Wildcat-Rocket-Engineering-Club/WRECtangle/Designs/PCB-DesignReviewFeedback.html

Export 563 message(s)



从 Wed Jan 07 2026 00:00:00 GMT-0700 (Mountain Standard Time) 到 Fri Feb 13 2026 00:00:00 GMT-0700 (Mountain Standard Time)

- 
  erzerumTue Feb 03 2026 21:35:38 GMT-0700 (Mountain Standard Time)
  @mr_arson#0
- 
  mr_arsonTue Feb 03 2026 21:35:42 GMT-0700 (Mountain Standard Time)
  okay chat
- 
  destroyo123Tue Feb 03 2026 21:35:46 GMT-0700 (Mountain Standard Time)
  hello!
- 
  mr_arsonTue Feb 03 2026 21:35:46 GMT-0700 (Mountain Standard Time)
  here is the bit
- 
  erzerumTue Feb 03 2026 21:35:46 GMT-0700 (Mountain Standard Time)
  cross country pcb review
- 
  destroyo123Tue Feb 03 2026 21:35:53 GMT-0700 (Mountain Standard Time)
  it is board review time
- 
  mr_arsonTue Feb 03 2026 21:35:59 GMT-0700 (Mountain Standard Time)
  have you ordered a pcb before
- 
  destroyo123Tue Feb 03 2026 21:36:04 GMT-0700 (Mountain Standard Time)
  this was first
- 
  destroyo123Tue Feb 03 2026 21:37:08 GMT-0700 (Mountain Standard Time)
- 
  mr_arsonTue Feb 03 2026 21:37:30 GMT-0700 (Mountain Standard Time)
  I think you could do a pretty good job competing with the average senior electrical engineer from my university at pcb design
- 
  destroyo123Tue Feb 03 2026 21:37:52 GMT-0700 (Mountain Standard Time)
  no way
- 
  destroyo123Tue Feb 03 2026 21:37:55 GMT-0700 (Mountain Standard Time)
  that's huge
- 
  destroyo123Tue Feb 03 2026 21:38:16 GMT-0700 (Mountain Standard Time)
  still probably a lot of issues I didn't even have time to adjust the silkscreens
- 
  destroyo123Tue Feb 03 2026 21:38:21 GMT-0700 (Mountain Standard Time)
  but that's huge thank you
- 
  mr_arsonTue Feb 03 2026 21:39:02 GMT-0700 (Mountain Standard Time)
  people take like a whole semester of "how mosfets physically work on the silicon level" and then don't put pulldown resistors it's a huge meme
- 
  destroyo123Tue Feb 03 2026 21:39:27 GMT-0700 (Mountain Standard Time)
  heh Yeah that sounds kinda funny
- 
  destroyo123Tue Feb 03 2026 21:39:32 GMT-0700 (Mountain Standard Time)
  "why is it still on?"
- 
  mr_arsonTue Feb 03 2026 21:40:19 GMT-0700 (Mountain Standard Time)
  once i placed series capacitors on the gate drive of fets. they would turn on for ~200ms. that was an ordering mistake tho
- 
  mr_arsonTue Feb 03 2026 21:41:10 GMT-0700 (Mountain Standard Time)
  what are we doing
  图片附件
- 
  destroyo123Tue Feb 03 2026 21:41:14 GMT-0700 (Mountain Standard Time)
  gate drive is the trigger signal basically right? so it would just stay on a little longer
- 
  mr_arsonTue Feb 03 2026 21:41:22 GMT-0700 (Mountain Standard Time)
  no because series capacitor blocks dc
- 
  destroyo123Tue Feb 03 2026 21:41:31 GMT-0700 (Mountain Standard Time)
  @mr_arson#0 okay so TI Powerbench told me to
- 
  destroyo123Tue Feb 03 2026 21:41:38 GMT-0700 (Mountain Standard Time)
  because I don't know how to design a power system
- 
  destroyo123Tue Feb 03 2026 21:41:53 GMT-0700 (Mountain Standard Time)
  📎 3.3V-Circuit.pdf?ex=6990a5d1&is=698f5451&hm=4855e791037637a58043e073c8e2e341926000bcf0f89aaae055b9305625b81f& (https://cdn.discordapp.com/attachments/1468464998379425875/1468466570685714432/3.3V-Circuit.pdf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)
- 
  mr_arsonTue Feb 03 2026 21:42:03 GMT-0700 (Mountain Standard Time)
  smart move
- 
  mr_arsonTue Feb 03 2026 21:42:03 GMT-0700 (Mountain Standard Time)
  however
- 
  destroyo123Tue Feb 03 2026 21:42:10 GMT-0700 (Mountain Standard Time)
  this is true
- 
  mr_arsonTue Feb 03 2026 21:42:13 GMT-0700 (Mountain Standard Time)
  when you put capacitors in series they do this bullshit
- 
  mr_arsonTue Feb 03 2026 21:42:48 GMT-0700 (Mountain Standard Time)
  图片附件
- 
  mr_arsonTue Feb 03 2026 21:42:56 GMT-0700 (Mountain Standard Time)
  halves the capacitance. or thirds it, in this case
- 
  destroyo123Tue Feb 03 2026 21:43:09 GMT-0700 (Mountain Standard Time)
  riiiiht?
- 
  mr_arsonTue Feb 03 2026 21:43:16 GMT-0700 (Mountain Standard Time)
  ti wants you to put them in parallel to increase the capacitance
- 
  destroyo123Tue Feb 03 2026 21:43:18 GMT-0700 (Mountain Standard Time)
  oh.
- 
  destroyo123Tue Feb 03 2026 21:43:21 GMT-0700 (Mountain Standard Time)
  dammit
- 
  mr_arsonTue Feb 03 2026 21:43:22 GMT-0700 (Mountain Standard Time)
  series capacitors are a no-go
- 
  mr_arsonTue Feb 03 2026 21:43:29 GMT-0700 (Mountain Standard Time)
  the only reason is to increase voltage ratings
- 
  destroyo123Tue Feb 03 2026 21:43:32 GMT-0700 (Mountain Standard Time)
  okay so that was misinterpereting the datasheet
- 
  mr_arsonTue Feb 03 2026 21:43:33 GMT-0700 (Mountain Standard Time)
  but that has other big problems
- 
  destroyo123Tue Feb 03 2026 21:43:45 GMT-0700 (Mountain Standard Time)
  darn
- 
  destroyo123Tue Feb 03 2026 21:43:46 GMT-0700 (Mountain Standard Time)
  good to know
- 
  mr_arsonTue Feb 03 2026 21:43:48 GMT-0700 (Mountain Standard Time)
  the datasheet tells you to place something about 10u
- 
  destroyo123Tue Feb 03 2026 21:44:08 GMT-0700 (Mountain Standard Time)
  could be fixed by bridging the other two and then putting one equivalent cap
- 
  mr_arsonTue Feb 03 2026 21:44:22 GMT-0700 (Mountain Standard Time)
  wait did you order this already
- 
  destroyo123Tue Feb 03 2026 21:44:25 GMT-0700 (Mountain Standard Time)
  yes
- 
  destroyo123Tue Feb 03 2026 21:44:39 GMT-0700 (Mountain Standard Time)
  I also made the mistake of not having them assemble it
- 
  destroyo123Tue Feb 03 2026 21:44:42 GMT-0700 (Mountain Standard Time)
  I have regrets
- 
  erzerumTue Feb 03 2026 21:44:45 GMT-0700 (Mountain Standard Time)
  lol
- 
  erzerumTue Feb 03 2026 21:44:49 GMT-0700 (Mountain Standard Time)
  told you so
- 
  mr_arsonTue Feb 03 2026 21:44:49 GMT-0700 (Mountain Standard Time)
  chat
- 
  destroyo123Tue Feb 03 2026 21:45:05 GMT-0700 (Mountain Standard Time)
  you were probably pretty right on that one
- 
  mr_arsonTue Feb 03 2026 21:45:12 GMT-0700 (Mountain Standard Time)
  图片附件
- 
  mr_arsonTue Feb 03 2026 21:45:52 GMT-0700 (Mountain Standard Time)
  have fun bodging that
  图片附件
- 
  mr_arsonTue Feb 03 2026 21:46:06 GMT-0700 (Mountain Standard Time)
  oh man its wqfn too
- 
  destroyo123Tue Feb 03 2026 21:46:11 GMT-0700 (Mountain Standard Time)
  ah fuck I even ran a DRC
- 
  destroyo123Tue Feb 03 2026 21:46:14 GMT-0700 (Mountain Standard Time)
  dammit
- 
  mr_arsonTue Feb 03 2026 21:46:23 GMT-0700 (Mountain Standard Time)
  it's worth running ERC even tho half of ERC is dumb bullshit
- 
  mr_arsonTue Feb 03 2026 21:46:33 GMT-0700 (Mountain Standard Time)
  but also this is what it looks like
- 
  mr_arsonTue Feb 03 2026 21:46:34 GMT-0700 (Mountain Standard Time)
  图片附件
- 
  destroyo123Tue Feb 03 2026 21:46:36 GMT-0700 (Mountain Standard Time)
  ERC is schematics?
- 
  mr_arsonTue Feb 03 2026 21:46:38 GMT-0700 (Mountain Standard Time)
  yea
- 
  mr_arsonTue Feb 03 2026 21:46:42 GMT-0700 (Mountain Standard Time)
  electrical rules checker or whatever
- 
  destroyo123Tue Feb 03 2026 21:46:42 GMT-0700 (Mountain Standard Time)
  how did I not
- 
  destroyo123Tue Feb 03 2026 21:46:43 GMT-0700 (Mountain Standard Time)
  know
- 
  destroyo123Tue Feb 03 2026 21:46:44 GMT-0700 (Mountain Standard Time)
  that
- 
  destroyo123Tue Feb 03 2026 21:46:45 GMT-0700 (Mountain Standard Time)
  these
- 
  destroyo123Tue Feb 03 2026 21:46:46 GMT-0700 (Mountain Standard Time)
  exist
- 
  mr_arsonTue Feb 03 2026 21:46:54 GMT-0700 (Mountain Standard Time)
  because it's mostly bullshit
- 
  destroyo123Tue Feb 03 2026 21:46:56 GMT-0700 (Mountain Standard Time)
  oh
- 
  mr_arsonTue Feb 03 2026 21:47:20 GMT-0700 (Mountain Standard Time)
  like it wants you to mark power rails and input/outputs and no one does that and it won't match your connectors anyway without explicit flags
- 
  mr_arsonTue Feb 03 2026 21:47:43 GMT-0700 (Mountain Standard Time)
  but it does catch you here
- 
  mr_arsonTue Feb 03 2026 21:47:44 GMT-0700 (Mountain Standard Time)
  图片附件
- 
  destroyo123Tue Feb 03 2026 21:47:45 GMT-0700 (Mountain Standard Time)
  oh interesting still I was looking for some tool to tell me if my schematics were good, that might have helped me
- 
  destroyo123Tue Feb 03 2026 21:47:49 GMT-0700 (Mountain Standard Time)
  yeah
- 
  mr_arsonTue Feb 03 2026 21:48:01 GMT-0700 (Mountain Standard Time)
  the real bit with your schematic is that it needs to be more standard and readable
- 
  mr_arsonTue Feb 03 2026 21:48:08 GMT-0700 (Mountain Standard Time)
  wait why did you order it without finishing the silk
- 
  destroyo123Tue Feb 03 2026 21:48:42 GMT-0700 (Mountain Standard Time)
  felt rushed because ordering is slow
- 
  mr_arsonTue Feb 03 2026 21:48:47 GMT-0700 (Mountain Standard Time)
  jlc?
- 
  destroyo123Tue Feb 03 2026 21:49:04 GMT-0700 (Mountain Standard Time)
  JLC yeah initially PCBway but the process for us as a club requires like 2 approvals from different offices
- 
  mr_arsonTue Feb 03 2026 21:49:12 GMT-0700 (Mountain Standard Time)
  jlc has never had a better holiday schedule
- 
  destroyo123Tue Feb 03 2026 21:49:25 GMT-0700 (Mountain Standard Time)
  JLC's timing was amazing
- 
  mr_arsonTue Feb 03 2026 21:49:35 GMT-0700 (Mountain Standard Time)
  2L is literally 6 day lead time to-door rn
- 
  destroyo123Tue Feb 03 2026 21:49:47 GMT-0700 (Mountain Standard Time)
  it's the offices and approvals that I was more concerned about yeah it was awesome
- 
  mr_arsonTue Feb 03 2026 21:49:59 GMT-0700 (Mountain Standard Time)
  ah i have heard a bit about purchasing being dumb, i am sorry
- 
  mr_arsonTue Feb 03 2026 21:50:18 GMT-0700 (Mountain Standard Time)
  i spent multiple thousands on jlcpcb.com at very late hours of the morning when i was in school without asking anyone
- 
  destroyo123Tue Feb 03 2026 21:50:34 GMT-0700 (Mountain Standard Time)
  no worries still another meh move on my part
- 
  mr_arsonTue Feb 03 2026 21:51:24 GMT-0700 (Mountain Standard Time)
  I have ordered literally the dumbest boards imaginable do not feel bad about it lmao
- 
  erzerumTue Feb 03 2026 21:51:39 GMT-0700 (Mountain Standard Time)
  if you want to do rev2 before 2/28 that could be club carded if we count on the musk money (yes that musk) coming in for real this time
- 
  destroyo123Tue Feb 03 2026 21:51:51 GMT-0700 (Mountain Standard Time)
  Yes that would be amazing and I will have JLC assemble it
- 
  mr_arsonTue Feb 03 2026 21:51:53 GMT-0700 (Mountain Standard Time)
  rev2 is going to cost you like thirty bucks more??
- 
  destroyo123Tue Feb 03 2026 21:52:38 GMT-0700 (Mountain Standard Time)
  we could then have 2x boards of spare parts in the event of mishap *if JLC lets me change how many boards get assembly
- 
  destroyo123Tue Feb 03 2026 21:52:54 GMT-0700 (Mountain Standard Time)
  it could still be really pricey if JLC requires all 5 to be assembled
- 
  mr_arsonTue Feb 03 2026 21:52:57 GMT-0700 (Mountain Standard Time)
  they will let you do minimum 2 maximum 5 iiirc
- 
  mr_arsonTue Feb 03 2026 21:53:00 GMT-0700 (Mountain Standard Time)
  but you have to pay reel costs
- 
  destroyo123Tue Feb 03 2026 21:53:07 GMT-0700 (Mountain Standard Time)
  shoot
- 
  destroyo123Tue Feb 03 2026 21:53:11 GMT-0700 (Mountain Standard Time)
  full reel
- 
  mr_arsonTue Feb 03 2026 21:53:17 GMT-0700 (Mountain Standard Time)
  if you already have parts on order from digi/mouser i would probably just do that
- 
  mr_arsonTue Feb 03 2026 21:53:18 GMT-0700 (Mountain Standard Time)
  no like
- 
  mr_arsonTue Feb 03 2026 21:53:22 GMT-0700 (Mountain Standard Time)
  lmao that would be fucked
- 
  destroyo123Tue Feb 03 2026 21:53:27 GMT-0700 (Mountain Standard Time)
  cut tape
- 
  mr_arsonTue Feb 03 2026 21:53:42 GMT-0700 (Mountain Standard Time)
  in the real world the worst-case is digikey/mouser re-reels your parts for seven bucks/part
- 
  mr_arsonTue Feb 03 2026 21:53:56 GMT-0700 (Mountain Standard Time)
  jlc charges like 1.50 per extended part or smth
- 
  destroyo123Tue Feb 03 2026 21:54:08 GMT-0700 (Mountain Standard Time)
  we have parts in inventory currently however I am finding it challenging to do SMD Turns out I accidentally got high-temp paste without realizing it but I also am not very good at using our stencil
- 
  mr_arsonTue Feb 03 2026 21:54:32 GMT-0700 (Mountain Standard Time)
  what have you tried to stencil already
- 
  erzerumTue Feb 03 2026 21:54:37 GMT-0700 (Mountain Standard Time)
  @destroyo123#0 told you lool
- 
  mr_arsonTue Feb 03 2026 21:54:44 GMT-0700 (Mountain Standard Time)
  woah jlc will sell you a stencil jig
- 
  mr_arsonTue Feb 03 2026 21:54:47 GMT-0700 (Mountain Standard Time)
  that's awesome
- 
  erzerumTue Feb 03 2026 21:54:52 GMT-0700 (Mountain Standard Time)
  @destroyo123#0 i mean thank you for your service
- 
  destroyo123Tue Feb 03 2026 21:54:52 GMT-0700 (Mountain Standard Time)
  we have a stencil with a frame
- 
  mr_arsonTue Feb 03 2026 21:55:02 GMT-0700 (Mountain Standard Time)
  another common mistep
- 
  destroyo123Tue Feb 03 2026 21:55:05 GMT-0700 (Mountain Standard Time)
  ah
- 
  destroyo123Tue Feb 03 2026 21:55:26 GMT-0700 (Mountain Standard Time)
  see I was thinking it would be nicer with the frame but actually doing it makes me realize the other way round
- 
  mr_arsonTue Feb 03 2026 21:55:46 GMT-0700 (Mountain Standard Time)
  you should order it custom sized, your pcb + 20mm on each side, with a preference to stay under 100mm^2 so you can fit into the $20 shipping box
- 
  mr_arsonTue Feb 03 2026 21:56:28 GMT-0700 (Mountain Standard Time)
  use other pcbs to keep it level with the one you're pasting, tape it down, use a flat plastic card (credit card sized but cheap and not embossed) as a spreader
- 
  destroyo123Tue Feb 03 2026 21:56:44 GMT-0700 (Mountain Standard Time)
  right
- 
  destroyo123Tue Feb 03 2026 21:57:02 GMT-0700 (Mountain Standard Time)
  @mr_arson#0 didn't see a custom size option for stencils but I guess that was for the framed one maybe
- 
  erzerumTue Feb 03 2026 21:57:04 GMT-0700 (Mountain Standard Time)
  @destroyo123#0 pvc nfc card
- 
  destroyo123Tue Feb 03 2026 21:57:08 GMT-0700 (Mountain Standard Time)
  @erzerum#0 real
- 
  mr_arsonTue Feb 03 2026 21:57:17 GMT-0700 (Mountain Standard Time)
  you have to select no frame yea
- 
  mr_arsonTue Feb 03 2026 21:57:36 GMT-0700 (Mountain Standard Time)
  the frame is awesome with a jig to hold it
- 
  mr_arsonTue Feb 03 2026 21:57:38 GMT-0700 (Mountain Standard Time)
  but like who has that
- 
  destroyo123Tue Feb 03 2026 21:57:43 GMT-0700 (Mountain Standard Time)
  not us
- 
  destroyo123Tue Feb 03 2026 21:57:46 GMT-0700 (Mountain Standard Time)
  but I can laser cut easily
- 
  mr_arsonTue Feb 03 2026 21:58:01 GMT-0700 (Mountain Standard Time)
  oh i guess you could make something work with that
- 
  mr_arsonTue Feb 03 2026 21:58:06 GMT-0700 (Mountain Standard Time)
  i got good enough with tape
- 
  mr_arsonTue Feb 03 2026 21:58:17 GMT-0700 (Mountain Standard Time)
  also saves you a ton on shipping
- 
  destroyo123Tue Feb 03 2026 21:58:32 GMT-0700 (Mountain Standard Time)
  yeah that was genuinely the highest cost driver of the board
- 
  destroyo123Tue Feb 03 2026 21:58:47 GMT-0700 (Mountain Standard Time)
  图片附件
- 
  mr_arsonTue Feb 03 2026 21:59:05 GMT-0700 (Mountain Standard Time)
  okay cool well ive got you down to 46 bucks shipped
- 
  mr_arsonTue Feb 03 2026 21:59:27 GMT-0700 (Mountain Standard Time)
  anyway
- 
  destroyo123Tue Feb 03 2026 21:59:47 GMT-0700 (Mountain Standard Time)
  well then we could also make JLC assemble it
- 
  mr_arsonTue Feb 03 2026 22:01:13 GMT-0700 (Mountain Standard Time)
  wow lcsc will sell you ublox chips
- 
  mr_arsonTue Feb 03 2026 22:01:14 GMT-0700 (Mountain Standard Time)
  crazy
- 
  destroyo123Tue Feb 03 2026 22:01:22 GMT-0700 (Mountain Standard Time)
  yummy
- 
  mr_arsonTue Feb 03 2026 22:01:29 GMT-0700 (Mountain Standard Time)
  https://jlcpcb.com/help/article/pcb-assembly-price
- 
  mr_arsonTue Feb 03 2026 22:02:08 GMT-0700 (Mountain Standard Time)
  $40+$1.5/part base cost for assembly+joints
- 
  mr_arsonTue Feb 03 2026 22:02:45 GMT-0700 (Mountain Standard Time)
  you have like 25 unique parts minus some basic-line passives, you can do math
- 
  mr_arsonTue Feb 03 2026 22:02:49 GMT-0700 (Mountain Standard Time)
  anyway
- 
  mr_arsonTue Feb 03 2026 22:03:02 GMT-0700 (Mountain Standard Time)
  if you do go for jlc assembly put the LCSC SKU for every single part
- 
  mr_arsonTue Feb 03 2026 22:03:12 GMT-0700 (Mountain Standard Time)
  if you put the MPN they'll mix it up
- 
  destroyo123Tue Feb 03 2026 22:03:22 GMT-0700 (Mountain Standard Time)
  MPN being Mouser
- 
  mr_arsonTue Feb 03 2026 22:03:28 GMT-0700 (Mountain Standard Time)
  manufacturer part number
- 
  destroyo123Tue Feb 03 2026 22:03:31 GMT-0700 (Mountain Standard Time)
  ah
- 
  mr_arsonTue Feb 03 2026 22:03:38 GMT-0700 (Mountain Standard Time)
  like TPS43060RTER
- 
  destroyo123Tue Feb 03 2026 22:03:49 GMT-0700 (Mountain Standard Time)
  sure yeah that's the MPN
- 
  mr_arsonTue Feb 03 2026 22:03:50 GMT-0700 (Mountain Standard Time)
  SKU - StockKeeper Unit name
- 
  destroyo123Tue Feb 03 2026 22:03:53 GMT-0700 (Mountain Standard Time)
  mhm
- 
  mr_arsonTue Feb 03 2026 22:03:54 GMT-0700 (Mountain Standard Time)
  C45678whatever
- 
  destroyo123Tue Feb 03 2026 22:03:59 GMT-0700 (Mountain Standard Time)
  图片附件
- 
  mr_arsonTue Feb 03 2026 22:04:16 GMT-0700 (Mountain Standard Time)
  only optional if you don't care if your board works
- 
  destroyo123Tue Feb 03 2026 22:04:22 GMT-0700 (Mountain Standard Time)
  figured
- 
  mr_arsonTue Feb 03 2026 22:05:45 GMT-0700 (Mountain Standard Time)
  do you put sponsers on your rocket
- 
  destroyo123Tue Feb 03 2026 22:06:01 GMT-0700 (Mountain Standard Time)
  we will I think
- 
  erzerumTue Feb 03 2026 22:06:15 GMT-0700 (Mountain Standard Time)
  yeah
- 
  mr_arsonTue Feb 03 2026 22:06:47 GMT-0700 (Mountain Standard Time)
  图片附件
- 
  mr_arsonTue Feb 03 2026 22:07:04 GMT-0700 (Mountain Standard Time)
  golden rule for SMPS schematics is to not have any overlapping lines and not have any nets
- 
  mr_arsonTue Feb 03 2026 22:07:23 GMT-0700 (Mountain Standard Time)
  图片附件
- 
  mr_arsonTue Feb 03 2026 22:07:24 GMT-0700 (Mountain Standard Time)
  like none of this
- 
  destroyo123Tue Feb 03 2026 22:07:43 GMT-0700 (Mountain Standard Time)
  so how are funky connections typically done?
- 
  mr_arsonTue Feb 03 2026 22:07:50 GMT-0700 (Mountain Standard Time)
  you'll notice that the pin numbers are not sequential here, that is because the pins are positioned to be optimally helpful for you to draw the clearest diagram
- 
  destroyo123Tue Feb 03 2026 22:07:56 GMT-0700 (Mountain Standard Time)
  oh
- 
  destroyo123Tue Feb 03 2026 22:08:15 GMT-0700 (Mountain Standard Time)
  noted I basically did a 1-for-1 with the Ti-WeBench schematic
- 
  mr_arsonTue Feb 03 2026 22:08:30 GMT-0700 (Mountain Standard Time)
  you'll notice that TI put BOOT on the top right
- 
  mr_arsonTue Feb 03 2026 22:08:34 GMT-0700 (Mountain Standard Time)
  did you make the symbol?
- 
  destroyo123Tue Feb 03 2026 22:08:45 GMT-0700 (Mountain Standard Time)
  no I think I downloaded a lot of the symbols from SnapEDA
- 
  mr_arsonTue Feb 03 2026 22:08:55 GMT-0700 (Mountain Standard Time)
  ypeah so whoever made the symbol is an idiot
- 
  destroyo123Tue Feb 03 2026 22:08:58 GMT-0700 (Mountain Standard Time)
  ha
- 
  mr_arsonTue Feb 03 2026 22:09:05 GMT-0700 (Mountain Standard Time)
  this is pretty common
- 
  mr_arsonTue Feb 03 2026 22:09:35 GMT-0700 (Mountain Standard Time)
  you should move pins in the symbol until you meet this rule
- 
  destroyo123Tue Feb 03 2026 22:09:44 GMT-0700 (Mountain Standard Time)
  sounds good
- 
  mr_arsonTue Feb 03 2026 22:09:46 GMT-0700 (Mountain Standard Time)
  this goes for every symbol, you should never be afraid to move pins
- 
  mr_arsonTue Feb 03 2026 22:09:56 GMT-0700 (Mountain Standard Time)
  in general, power and data should only move left-to-right or top-to-bottom
- 
  mr_arsonTue Feb 03 2026 22:10:09 GMT-0700 (Mountain Standard Time)
  on a SMPS, the standard is to have a visible ground rail
- 
  mr_arsonTue Feb 03 2026 22:10:21 GMT-0700 (Mountain Standard Time)
  you do a pretty good job of this on the left side but totally disapears on the right
- 
  destroyo123Tue Feb 03 2026 22:11:00 GMT-0700 (Mountain Standard Time)
  I see
- 
  mr_arsonTue Feb 03 2026 22:11:33 GMT-0700 (Mountain Standard Time)
  图片附件
- 
  mr_arsonTue Feb 03 2026 22:11:45 GMT-0700 (Mountain Standard Time)
  thinking about the red and purple loops here is important, so make your schematic reflect that
- 
  mr_arsonTue Feb 03 2026 22:11:50 GMT-0700 (Mountain Standard Time)
  we'll come back to that in a sec
- 
  destroyo123Tue Feb 03 2026 22:12:15 GMT-0700 (Mountain Standard Time)
  can you color wires in KiCAD?
- 
  mr_arsonTue Feb 03 2026 22:12:38 GMT-0700 (Mountain Standard Time)
  yeah but i would maybe avoid it. I would increase the thickness of "power carrying" signals
- 
  mr_arsonTue Feb 03 2026 22:13:07 GMT-0700 (Mountain Standard Time)
  use wires everywhere: again with comp, again with FB. move things around until it topologically works
- 
  mr_arsonTue Feb 03 2026 22:13:20 GMT-0700 (Mountain Standard Time)
  comp in general is a bit of a meme but just follow what ti webench says
- 
  destroyo123Tue Feb 03 2026 22:13:43 GMT-0700 (Mountain Standard Time)
  ah
- 
  mr_arsonTue Feb 03 2026 22:13:43 GMT-0700 (Mountain Standard Time)
  Cout-24V1 does not have an MPN
- 
  destroyo123Tue Feb 03 2026 22:14:04 GMT-0700 (Mountain Standard Time)
  was it in WeBench did I fuck that up
- 
  mr_arsonTue Feb 03 2026 22:14:18 GMT-0700 (Mountain Standard Time)
  make sure that is rated for 24V plus margin. exceeding voltage ratings on electrolytics = ~~explosion~~ shorting or venting
- 
  mr_arsonTue Feb 03 2026 22:14:24 GMT-0700 (Mountain Standard Time)
  no you just like didn't write down what it is
- 
  destroyo123Tue Feb 03 2026 22:14:41 GMT-0700 (Mountain Standard Time)
  oh oh Yes I think the capacitors in this are like 50V rated
- 
  mr_arsonTue Feb 03 2026 22:14:49 GMT-0700 (Mountain Standard Time)
  you have no clamp so i would hope so
- 
  destroyo123Tue Feb 03 2026 22:14:51 GMT-0700 (Mountain Standard Time)
  can double check but I picked higher ratings where possible
- 
  mr_arsonTue Feb 03 2026 22:14:56 GMT-0700 (Mountain Standard Time)
  50v is the lowest i would go there
- 
  destroyo123Tue Feb 03 2026 22:15:06 GMT-0700 (Mountain Standard Time)
  ah
- 
  destroyo123Tue Feb 03 2026 22:15:20 GMT-0700 (Mountain Standard Time)
  I guess inductors and other funny business could cause spikes
- 
  mr_arsonTue Feb 03 2026 22:15:36 GMT-0700 (Mountain Standard Time)
  on a SMPS schematic, no labels allowed including ground
  图片附件
- 
  mr_arsonTue Feb 03 2026 22:15:42 GMT-0700 (Mountain Standard Time)
  yeah
- 
  mr_arsonTue Feb 03 2026 22:15:43 GMT-0700 (Mountain Standard Time)
  i mean like
- 
  mr_arsonTue Feb 03 2026 22:15:53 GMT-0700 (Mountain Standard Time)
  lmao
  图片附件
- 
  mr_arsonTue Feb 03 2026 22:16:19 GMT-0700 (Mountain Standard Time)
  图片附件
- 
  mr_arsonTue Feb 03 2026 22:16:23 GMT-0700 (Mountain Standard Time)
  sometimes you mention the unit, sometimes you do not
- 
  mr_arsonTue Feb 03 2026 22:16:37 GMT-0700 (Mountain Standard Time)
  professionally I'd say you shouldn't but I've seen both. be consistent
- 
  destroyo123Tue Feb 03 2026 22:16:39 GMT-0700 (Mountain Standard Time)
  @mr_arson#0 so what do you mean no ground label
- 
  destroyo123Tue Feb 03 2026 22:16:44 GMT-0700 (Mountain Standard Time)
  stupid question maybe
- 
  mr_arsonTue Feb 03 2026 22:16:45 GMT-0700 (Mountain Standard Time)
  like draw a wire to ground
- 
  destroyo123Tue Feb 03 2026 22:16:53 GMT-0700 (Mountain Standard Time)
  ah
- 
  mr_arsonTue Feb 03 2026 22:16:57 GMT-0700 (Mountain Standard Time)
  like you know when you put a label and it makes a magical connection across the schematic
- 
  destroyo123Tue Feb 03 2026 22:17:03 GMT-0700 (Mountain Standard Time)
  yeah
- 
  mr_arsonTue Feb 03 2026 22:17:05 GMT-0700 (Mountain Standard Time)
  for a SMPS, you're not allowed to do that
- 
  destroyo123Tue Feb 03 2026 22:17:09 GMT-0700 (Mountain Standard Time)
  got it
- 
  mr_arsonTue Feb 03 2026 22:17:32 GMT-0700 (Mountain Standard Time)
  makes for a bad schematic
- 
  destroyo123Tue Feb 03 2026 22:17:52 GMT-0700 (Mountain Standard Time)
  @mr_arson#0 there isn't to my knowledge an easy way to type the ohm symbol fair point though it confused me a little on the BOM
- 
  destroyo123Tue Feb 03 2026 22:18:07 GMT-0700 (Mountain Standard Time)
  in the future will just say "ohm"
- 
  mr_arsonTue Feb 03 2026 22:18:26 GMT-0700 (Mountain Standard Time)
  i would personally just write nothing or make a keyboard shortcut for it lmao
- 
  mr_arsonTue Feb 03 2026 22:18:32 GMT-0700 (Mountain Standard Time)
  i have the greek language enabled on my work laptop
- 
  mr_arsonTue Feb 03 2026 22:18:53 GMT-0700 (Mountain Standard Time)
  get rid of this guy
  图片附件
- 
  destroyo123Tue Feb 03 2026 22:18:59 GMT-0700 (Mountain Standard Time)
  oh that's smart I should do that honestly I'm already used to swapping from Arabic and Hebrew
- 
  erzerumTue Feb 03 2026 22:19:07 GMT-0700 (Mountain Standard Time)
  verifiable
- 
  destroyo123Tue Feb 03 2026 22:19:15 GMT-0700 (Mountain Standard Time)
  @mr_arson#0 just an unnecessary GND?
- 
  destroyo123Tue Feb 03 2026 22:19:19 GMT-0700 (Mountain Standard Time)
  or the label
- 
  mr_arsonTue Feb 03 2026 22:19:22 GMT-0700 (Mountain Standard Time)
  it's not gnd it's 0V
- 
  mr_arsonTue Feb 03 2026 22:19:24 GMT-0700 (Mountain Standard Time)
  but you've connected them
- 
  destroyo123Tue Feb 03 2026 22:19:25 GMT-0700 (Mountain Standard Time)
  oh oh
- 
  mr_arsonTue Feb 03 2026 22:19:36 GMT-0700 (Mountain Standard Time)
  make sure you don't have any other 0V things or they'll be disconnected (when you delete this specific label connecting it to ground)
- 
  mr_arsonTue Feb 03 2026 22:19:39 GMT-0700 (Mountain Standard Time)
  (did that once)
- 
  mr_arsonTue Feb 03 2026 22:19:50 GMT-0700 (Mountain Standard Time)
  图片附件
- 
  destroyo123Tue Feb 03 2026 22:19:52 GMT-0700 (Mountain Standard Time)
  oh
- 
  mr_arsonTue Feb 03 2026 22:20:05 GMT-0700 (Mountain Standard Time)
  this is like, fine
- 
  mr_arsonTue Feb 03 2026 22:21:02 GMT-0700 (Mountain Standard Time)
  图片附件
- 
  mr_arsonTue Feb 03 2026 22:21:08 GMT-0700 (Mountain Standard Time)
  drawn in purple is the current path
- 
  mr_arsonTue Feb 03 2026 22:21:21 GMT-0700 (Mountain Standard Time)
  the yellow mark (about 5mm) is 5mOhm at your trace width
- 
  mr_arsonTue Feb 03 2026 22:21:35 GMT-0700 (Mountain Standard Time)
  substantially dominating the 7mOhm resistance of the current shunt
- 
  mr_arsonTue Feb 03 2026 22:21:48 GMT-0700 (Mountain Standard Time)
  https://en.wikipedia.org/wiki/Four-terminal_sensing the layout shown here is good
- 
  mr_arsonTue Feb 03 2026 22:22:15 GMT-0700 (Mountain Standard Time)
  on the topic of this, what are you trying to hit, 3A?
- 
  mr_arsonTue Feb 03 2026 22:23:10 GMT-0700 (Mountain Standard Time)
  ty for writing that in the schematic BTW. it's a really good habit to document those design decisions
- 
  mr_arsonTue Feb 03 2026 22:23:16 GMT-0700 (Mountain Standard Time)
  your trace is going to get toasty but not explode
  图片附件
- 
  destroyo123Tue Feb 03 2026 22:23:44 GMT-0700 (Mountain Standard Time)
  for the 24V circuit peak was roughly 3A yeah designed to support 2x 24V solenoids of 10W rated , so 417mA each or 1A roughly Plus I think the 5V circuit is based on the 24V power as a baseline
- 
  destroyo123Tue Feb 03 2026 22:24:02 GMT-0700 (Mountain Standard Time)
  good to know
- 
  destroyo123Tue Feb 03 2026 22:25:43 GMT-0700 (Mountain Standard Time)
  is that calculator built into KiCAD?
- 
  mr_arsonTue Feb 03 2026 22:26:36 GMT-0700 (Mountain Standard Time)
  yeah
- 
  mr_arsonTue Feb 03 2026 22:26:38 GMT-0700 (Mountain Standard Time)
  图片附件
- 
  mr_arsonTue Feb 03 2026 22:26:41 GMT-0700 (Mountain Standard Time)
  this is the red loop from earlier
- 
  destroyo123Tue Feb 03 2026 22:27:14 GMT-0700 (Mountain Standard Time)
  @mr_arson#0 oh this guy
- 
  mr_arsonTue Feb 03 2026 22:27:26 GMT-0700 (Mountain Standard Time)
  yep
- 
  mr_arsonTue Feb 03 2026 22:27:29 GMT-0700 (Mountain Standard Time)
  this guy is bouncing around at
- 
  mr_arsonTue Feb 03 2026 22:27:30 GMT-0700 (Mountain Standard Time)
  whatever
- 
  mr_arsonTue Feb 03 2026 22:27:34 GMT-0700 (Mountain Standard Time)
  lots of hertz
- 
  destroyo123Tue Feb 03 2026 22:27:48 GMT-0700 (Mountain Standard Time)
  oh
- 
  destroyo123Tue Feb 03 2026 22:27:58 GMT-0700 (Mountain Standard Time)
  that's too excited to be happy
- 
  mr_arsonTue Feb 03 2026 22:28:21 GMT-0700 (Mountain Standard Time)
  it's also like 5A
- 
  mr_arsonTue Feb 03 2026 22:28:30 GMT-0700 (Mountain Standard Time)
  or maybe more depending on your input voltage
- 
  mr_arsonTue Feb 03 2026 22:28:47 GMT-0700 (Mountain Standard Time)
  you should optimize this layout to minimize this loop area
- 
  mr_arsonTue Feb 03 2026 22:29:03 GMT-0700 (Mountain Standard Time)
  is the tldr
- 
  destroyo123Tue Feb 03 2026 22:29:14 GMT-0700 (Mountain Standard Time)
  alrighty try and keep power loops shorter
- 
  mr_arsonTue Feb 03 2026 22:29:22 GMT-0700 (Mountain Standard Time)
  specifically high frequency loops
- 
  destroyo123Tue Feb 03 2026 22:29:36 GMT-0700 (Mountain Standard Time)
  which will be from the power microelectronics like those Ti regulators
- 
  mr_arsonTue Feb 03 2026 22:29:37 GMT-0700 (Mountain Standard Time)
  there's also a 0.25mm trace in there which will get very toasty but probably not blow up maybe no promises
- 
  mr_arsonTue Feb 03 2026 22:29:40 GMT-0700 (Mountain Standard Time)
  yes
- 
  destroyo123Tue Feb 03 2026 22:29:42 GMT-0700 (Mountain Standard Time)
  the switching components
- 
  destroyo123Tue Feb 03 2026 22:29:47 GMT-0700 (Mountain Standard Time)
  @mr_arson#0 noted
- 
  mr_arsonTue Feb 03 2026 22:30:34 GMT-0700 (Mountain Standard Time)
  about 0.5mhz
- 
  destroyo123Tue Feb 03 2026 22:30:42 GMT-0700 (Mountain Standard Time)
  oh okay that is quite fast
- 
  mr_arsonTue Feb 03 2026 22:31:24 GMT-0700 (Mountain Standard Time)
  图片附件
- 
  destroyo123Tue Feb 03 2026 22:31:56 GMT-0700 (Mountain Standard Time)
  is this.... about the same thing?
- 
  mr_arsonTue Feb 03 2026 22:32:03 GMT-0700 (Mountain Standard Time)
  yeah lmao
- 
  mr_arsonTue Feb 03 2026 22:32:08 GMT-0700 (Mountain Standard Time)
  this is a bit to be clear
- 
  mr_arsonTue Feb 03 2026 22:32:27 GMT-0700 (Mountain Standard Time)
  i think it might work but you definitely have a chance to have emi problems
- 
  mr_arsonTue Feb 03 2026 22:33:15 GMT-0700 (Mountain Standard Time)
  you should also definitely just pay more attention to trace thickness in general. copper is free, you might as well use it
- 
  mr_arsonTue Feb 03 2026 22:33:26 GMT-0700 (Mountain Standard Time)
  blanket statement for the entire board
- 
  mr_arsonTue Feb 03 2026 22:34:01 GMT-0700 (Mountain Standard Time)
  for some reason you have this weird triangle on your paste layer
  图片附件
- 
  mr_arsonTue Feb 03 2026 22:34:05 GMT-0700 (Mountain Standard Time)
  suboptimal, that'll be in your stencil
- 
  destroyo123Tue Feb 03 2026 22:34:32 GMT-0700 (Mountain Standard Time)
  noted Oh actually on that note There is a component that wanted 50-Ohm impedance controlled trace I wasn't sure if there was an automatic route thing that could do that
- 
  destroyo123Tue Feb 03 2026 22:34:43 GMT-0700 (Mountain Standard Time)
  @mr_arson#0 ah yeah I think the JLC people actually may have fixed that one
- 
  mr_arsonTue Feb 03 2026 22:34:48 GMT-0700 (Mountain Standard Time)
  LMAO yeah they do that
- 
  destroyo123Tue Feb 03 2026 22:34:49 GMT-0700 (Mountain Standard Time)
  wildly enough
- 
  destroyo123Tue Feb 03 2026 22:34:55 GMT-0700 (Mountain Standard Time)
  W JLC yet again
- 
  mr_arsonTue Feb 03 2026 22:34:57 GMT-0700 (Mountain Standard Time)
  what's this mosfet
- 
  mr_arsonTue Feb 03 2026 22:35:08 GMT-0700 (Mountain Standard Time)
  i promise you that pad 9 is connected to something
- 
  mr_arsonTue Feb 03 2026 22:35:37 GMT-0700 (Mountain Standard Time)
  this goes back to, you should be making or at minimum validating your symbols and footprints 100% of the time. do not trust easyeda. people put the dumbest shit on there. people put even dumber shit on the digikey one. it is all bad
- 
  mr_arsonTue Feb 03 2026 22:35:49 GMT-0700 (Mountain Standard Time)
  but that should definitely be connected to something
- 
  destroyo123Tue Feb 03 2026 22:35:54 GMT-0700 (Mountain Standard Time)
  shoot
- 
  destroyo123Tue Feb 03 2026 22:36:02 GMT-0700 (Mountain Standard Time)
  looking into it
- 
  mr_arsonTue Feb 03 2026 22:36:11 GMT-0700 (Mountain Standard Time)
  same with pad 5 on
- 
  mr_arsonTue Feb 03 2026 22:36:15 GMT-0700 (Mountain Standard Time)
  M1-24V1
- 
  mr_arsonTue Feb 03 2026 22:36:49 GMT-0700 (Mountain Standard Time)
  idk where you got these reference designators from (refdegs for short) but industry standard is , or 0
- 
  mr_arsonTue Feb 03 2026 22:36:56 GMT-0700 (Mountain Standard Time)
  like Q205 for the latter
- 
  destroyo123Tue Feb 03 2026 22:37:05 GMT-0700 (Mountain Standard Time)
  KiCAD wanted me to make them so I made them up
- 
  destroyo123Tue Feb 03 2026 22:37:15 GMT-0700 (Mountain Standard Time)
  consider my naming scheme pulled out of my ass
- 
  destroyo123Tue Feb 03 2026 22:37:20 GMT-0700 (Mountain Standard Time)
  that is useful information
- 
  mr_arsonTue Feb 03 2026 22:37:21 GMT-0700 (Mountain Standard Time)
  you should write "Q?" and then use the auto refdeg tool
- 
  mr_arsonTue Feb 03 2026 22:37:33 GMT-0700 (Mountain Standard Time)
  and then before you order the board you should use the "assign refdegs based on physical location" tool
- 
  mr_arsonTue Feb 03 2026 22:37:37 GMT-0700 (Mountain Standard Time)
  makes you look like a pro
- 
  destroyo123Tue Feb 03 2026 22:37:47 GMT-0700 (Mountain Standard Time)
  oh that sounds like a sick tool
- 
  mr_arsonTue Feb 03 2026 22:38:11 GMT-0700 (Mountain Standard Time)
  again, trace width. also 1 via is rated for about 2A
  图片附件
- 
  mr_arsonTue Feb 03 2026 22:38:23 GMT-0700 (Mountain Standard Time)
  you'd get away with this because you have bigger vias but worth keeping in mind
- 
  mr_arsonTue Feb 03 2026 22:38:41 GMT-0700 (Mountain Standard Time)
  just to be sure you do this, you do need to 4-wire kelvin sense the current shunt resistors
- 
  destroyo123Tue Feb 03 2026 22:39:19 GMT-0700 (Mountain Standard Time)
  it just looks like a FET to me
  图片附件
- 
  mr_arsonTue Feb 03 2026 22:39:28 GMT-0700 (Mountain Standard Time)
  look at the footprint
- 
  mr_arsonTue Feb 03 2026 22:39:44 GMT-0700 (Mountain Standard Time)
  also it very clearly says that pins 5-8 are connected to drain
- 
  mr_arsonTue Feb 03 2026 22:39:50 GMT-0700 (Mountain Standard Time)
  cute fet tho
- 
  destroyo123Tue Feb 03 2026 22:40:20 GMT-0700 (Mountain Standard Time)
  oh this is where pulldown
- 
  mr_arsonTue Feb 03 2026 22:41:03 GMT-0700 (Mountain Standard Time)
  TPS55289RYQR is an insane part
- 
  destroyo123Tue Feb 03 2026 22:41:08 GMT-0700 (Mountain Standard Time)
  I wonder if that was a me being stupid thing or me trusting SnapEDA or a webench thing
- 
  mr_arsonTue Feb 03 2026 22:41:17 GMT-0700 (Mountain Standard Time)
  all three
- 
  mr_arsonTue Feb 03 2026 22:41:19 GMT-0700 (Mountain Standard Time)
  actually just the first two
- 
  mr_arsonTue Feb 03 2026 22:41:40 GMT-0700 (Mountain Standard Time)
  TPS55289RYQR is programmable with I2C however you did not hook up I2C
- 
  mr_arsonTue Feb 03 2026 22:41:47 GMT-0700 (Mountain Standard Time)
  also all the same comments about SMPS apply
- 
  destroyo123Tue Feb 03 2026 22:42:00 GMT-0700 (Mountain Standard Time)
  I figured I did not need so did not hook up to the line
- 
  mr_arsonTue Feb 03 2026 22:42:04 GMT-0700 (Mountain Standard Time)
  also this looks like hell to reflow
  图片附件
- 
  destroyo123Tue Feb 03 2026 22:42:08 GMT-0700 (Mountain Standard Time)
  yeah...
- 
  mr_arsonTue Feb 03 2026 22:42:26 GMT-0700 (Mountain Standard Time)
  how is it going to know what voltage to output
- 
  mr_arsonTue Feb 03 2026 22:42:30 GMT-0700 (Mountain Standard Time)
  what's your current draw on 3v3
- 
  mr_arsonTue Feb 03 2026 22:42:58 GMT-0700 (Mountain Standard Time)
  ballpark
- 
  mr_arsonTue Feb 03 2026 22:43:14 GMT-0700 (Mountain Standard Time)
  this guy should be a polarized symbol as you have a polarized cap on it
  图片附件
- 
  destroyo123Tue Feb 03 2026 22:43:17 GMT-0700 (Mountain Standard Time)
  roughly 400mA for the 3.3V components
- 
  destroyo123Tue Feb 03 2026 22:43:34 GMT-0700 (Mountain Standard Time)
  maybe 450mA
- 
  mr_arsonTue Feb 03 2026 22:44:25 GMT-0700 (Mountain Standard Time)
  bodge an LD1117V33C on
- 
  mr_arsonTue Feb 03 2026 22:44:32 GMT-0700 (Mountain Standard Time)
  and then place it on the next rev
- 
  destroyo123Tue Feb 03 2026 22:44:51 GMT-0700 (Mountain Standard Time)
  okey dokey more power
- 
  mr_arsonTue Feb 03 2026 22:45:17 GMT-0700 (Mountain Standard Time)
  uh wait you're stepping down from 24v
- 
  mr_arsonTue Feb 03 2026 22:45:19 GMT-0700 (Mountain Standard Time)
  that won't work
- 
  mr_arsonTue Feb 03 2026 22:45:32 GMT-0700 (Mountain Standard Time)
  maybe LD1086V33-DG
- 
  mr_arsonTue Feb 03 2026 22:45:36 GMT-0700 (Mountain Standard Time)
  or some bullshit idc
- 
  destroyo123Tue Feb 03 2026 22:45:50 GMT-0700 (Mountain Standard Time)
  the 3.3V power setup is actually stepped down from batteries
- 
  destroyo123Tue Feb 03 2026 22:46:00 GMT-0700 (Mountain Standard Time)
  3S Li-Po , so roughly like 13-14V max
- 
  mr_arsonTue Feb 03 2026 22:46:11 GMT-0700 (Mountain Standard Time)
  oh sweet then yeah ldo is perfect
- 
  mr_arsonTue Feb 03 2026 22:46:24 GMT-0700 (Mountain Standard Time)
  same for the 5V rail
- 
  mr_arsonTue Feb 03 2026 22:46:31 GMT-0700 (Mountain Standard Time)
  though your 5V rail is way nicer
- 
  mr_arsonTue Feb 03 2026 22:46:56 GMT-0700 (Mountain Standard Time)
  this is an electrolytic and needs to be rated at least 40% higher voltage
  图片附件
- 
  mr_arsonTue Feb 03 2026 22:47:01 GMT-0700 (Mountain Standard Time)
  and marked as such in the schematic
- 
  mr_arsonTue Feb 03 2026 22:47:04 GMT-0700 (Mountain Standard Time)
  with the polarized symbol
- 
  destroyo123Tue Feb 03 2026 22:47:16 GMT-0700 (Mountain Standard Time)
  oh noted
- 
  mr_arsonTue Feb 03 2026 22:47:20 GMT-0700 (Mountain Standard Time)
  but the diagram looks nice
- 
  destroyo123Tue Feb 03 2026 22:47:23 GMT-0700 (Mountain Standard Time)
  Thanks
- 
  mr_arsonTue Feb 03 2026 22:47:26 GMT-0700 (Mountain Standard Time)
  except for BOOT
- 
  mr_arsonTue Feb 03 2026 22:47:31 GMT-0700 (Mountain Standard Time)
  and PG and FB are switched
- 
  mr_arsonTue Feb 03 2026 22:47:46 GMT-0700 (Mountain Standard Time)
  oh and this is going to suck to solder
- 
  destroyo123Tue Feb 03 2026 22:48:02 GMT-0700 (Mountain Standard Time)
  yeah..
- 
  mr_arsonTue Feb 03 2026 22:48:05 GMT-0700 (Mountain Standard Time)
  what's the current draw on 5v?
- 
  destroyo123Tue Feb 03 2026 22:49:01 GMT-0700 (Mountain Standard Time)
  that one in theory, if all servos go on at once could reach roughly 5A
- 
  destroyo123Tue Feb 03 2026 22:49:10 GMT-0700 (Mountain Standard Time)
  but in reality probably not
- 
  mr_arsonTue Feb 03 2026 22:49:21 GMT-0700 (Mountain Standard Time)
  yeah that should be a buck converter or a big capacitor then
- 
  destroyo123Tue Feb 03 2026 22:49:25 GMT-0700 (Mountain Standard Time)
  scratch that if all servos are at stall current at once
- 
  destroyo123Tue Feb 03 2026 22:49:30 GMT-0700 (Mountain Standard Time)
  there is a 1000uF cap on for those peaks
- 
  mr_arsonTue Feb 03 2026 22:49:30 GMT-0700 (Mountain Standard Time)
  yea plan on it. don't trust those meches
- 
  mr_arsonTue Feb 03 2026 22:49:49 GMT-0700 (Mountain Standard Time)
  this is definitely not correct
  图片附件
- 
  destroyo123Tue Feb 03 2026 22:49:54 GMT-0700 (Mountain Standard Time)
  fuck
- 
  destroyo123Tue Feb 03 2026 22:50:11 GMT-0700 (Mountain Standard Time)
  these are intended to switch solenoids (24V) on/off
- 
  destroyo123Tue Feb 03 2026 22:50:25 GMT-0700 (Mountain Standard Time)
  via a 3.3V logic voltage
- 
  mr_arsonTue Feb 03 2026 22:52:01 GMT-0700 (Mountain Standard Time)
  图片附件
- 
  mr_arsonTue Feb 03 2026 22:52:50 GMT-0700 (Mountain Standard Time)
  oh wait this isn't a zener
- 
  mr_arsonTue Feb 03 2026 22:53:53 GMT-0700 (Mountain Standard Time)
  oh but i guess it's fine
- 
  destroyo123Tue Feb 03 2026 22:53:54 GMT-0700 (Mountain Standard Time)
  standard diode to my knowledge
- 
  destroyo123Tue Feb 03 2026 22:53:57 GMT-0700 (Mountain Standard Time)
  just a regular diode used for flyback
- 
  mr_arsonTue Feb 03 2026 22:54:01 GMT-0700 (Mountain Standard Time)
  i would put a 30V zener on the mosfet
- 
  mr_arsonTue Feb 03 2026 22:54:08 GMT-0700 (Mountain Standard Time)
  just to be careful
- 
  destroyo123Tue Feb 03 2026 22:54:29 GMT-0700 (Mountain Standard Time)
  okay..
- 
  destroyo123Tue Feb 03 2026 22:54:43 GMT-0700 (Mountain Standard Time)
  30V zener diode recommended in addition to the flyback diode?
- 
  destroyo123Tue Feb 03 2026 22:54:45 GMT-0700 (Mountain Standard Time)
  or to replace
- 
  mr_arsonTue Feb 03 2026 22:54:48 GMT-0700 (Mountain Standard Time)
  that'll conduct forwards only when the voltage across it is >=30V
- 
  mr_arsonTue Feb 03 2026 22:54:53 GMT-0700 (Mountain Standard Time)
  so it'll clamp the voltage to 30V
- 
  mr_arsonTue Feb 03 2026 22:54:56 GMT-0700 (Mountain Standard Time)
  in the case of spikes
- 
  mr_arsonTue Feb 03 2026 22:54:57 GMT-0700 (Mountain Standard Time)
  yeah
- 
  mr_arsonTue Feb 03 2026 22:55:08 GMT-0700 (Mountain Standard Time)
  but the flyback is the important one I'm just paranoid. the flyback will be fine
- 
  mr_arsonTue Feb 03 2026 22:55:11 GMT-0700 (Mountain Standard Time)
  图片附件
- 
  destroyo123Tue Feb 03 2026 22:55:30 GMT-0700 (Mountain Standard Time)
  thank you
- 
  mr_arsonTue Feb 03 2026 22:55:44 GMT-0700 (Mountain Standard Time)
  I know it says 3A on the package
- 
  mr_arsonTue Feb 03 2026 22:55:48 GMT-0700 (Mountain Standard Time)
  datasheet
- 
  mr_arsonTue Feb 03 2026 22:55:49 GMT-0700 (Mountain Standard Time)
  whatever
- 
  mr_arsonTue Feb 03 2026 22:55:55 GMT-0700 (Mountain Standard Time)
  they lie
- 
  destroyo123Tue Feb 03 2026 22:56:01 GMT-0700 (Mountain Standard Time)
  oh :(
- 
  destroyo123Tue Feb 03 2026 22:56:20 GMT-0700 (Mountain Standard Time)
  why would anyone ever lie to make their spec seem more impressive than it really is???
- 
  mr_arsonTue Feb 03 2026 22:56:38 GMT-0700 (Mountain Standard Time)
  because you could cool it really really well
- 
  mr_arsonTue Feb 03 2026 22:56:43 GMT-0700 (Mountain Standard Time)
  but you won't
- 
  destroyo123Tue Feb 03 2026 22:56:55 GMT-0700 (Mountain Standard Time)
  nah this john's going into a fiberglass container
- 
  mr_arsonTue Feb 03 2026 22:57:10 GMT-0700 (Mountain Standard Time)
  how long is it going to be on for?
- 
  destroyo123Tue Feb 03 2026 22:57:43 GMT-0700 (Mountain Standard Time)
  battery calculations should last for ~2hr max realistically probably like 30min
- 
  mr_arsonTue Feb 03 2026 22:57:56 GMT-0700 (Mountain Standard Time)
  no, the solonoid
- 
  destroyo123Tue Feb 03 2026 22:58:03 GMT-0700 (Mountain Standard Time)
  30min
- 
  mr_arsonTue Feb 03 2026 22:58:04 GMT-0700 (Mountain Standard Time)
  pulse width and duty cycle
- 
  destroyo123Tue Feb 03 2026 22:58:08 GMT-0700 (Mountain Standard Time)
  oh
- 
  destroyo123Tue Feb 03 2026 22:58:11 GMT-0700 (Mountain Standard Time)
  on/off effectively
- 
  destroyo123Tue Feb 03 2026 22:58:14 GMT-0700 (Mountain Standard Time)
  not being pulsed
- 
  mr_arsonTue Feb 03 2026 22:58:21 GMT-0700 (Mountain Standard Time)
  oh so just on for 30 min
- 
  erzerumTue Feb 03 2026 22:58:39 GMT-0700 (Mountain Standard Time)
  @mr_arson#0 some vents in there too during fill
- 
  destroyo123Tue Feb 03 2026 22:58:41 GMT-0700 (Mountain Standard Time)
  originally wanted to use them for RCS but ultimately decided not to for other reasons so it's just a normally-open valve we gotta hold open for like 30min somewhat
- 
  destroyo123Tue Feb 03 2026 22:58:43 GMT-0700 (Mountain Standard Time)
  yeah
- 
  mr_arsonTue Feb 03 2026 22:58:45 GMT-0700 (Mountain Standard Time)
  图片附件
- 
  erzerumTue Feb 03 2026 22:58:50 GMT-0700 (Mountain Standard Time)
  except that the solenoid got cut cause they sent us the wrong one
- 
  mr_arsonTue Feb 03 2026 22:58:53 GMT-0700 (Mountain Standard Time)
  realistically you'll get 40mA out of this fet before it blows up then
- 
  destroyo123Tue Feb 03 2026 22:59:06 GMT-0700 (Mountain Standard Time)
  oh
- 
  destroyo123Tue Feb 03 2026 22:59:09 GMT-0700 (Mountain Standard Time)
  shit
- 
  mr_arsonTue Feb 03 2026 22:59:12 GMT-0700 (Mountain Standard Time)
  sorry wait im dumb this is the wrong graph
- 
  mr_arsonTue Feb 03 2026 22:59:17 GMT-0700 (Mountain Standard Time)
  it's vgs
- 
  mr_arsonTue Feb 03 2026 22:59:43 GMT-0700 (Mountain Standard Time)
  but you're still somewhere in here
  图片附件
- 
  mr_arsonTue Feb 03 2026 22:59:49 GMT-0700 (Mountain Standard Time)
  and it's still too small of a fet
- 
  destroyo123Tue Feb 03 2026 23:00:05 GMT-0700 (Mountain Standard Time)
  I feel like I checked the currents but transistor terminology is definitely still harder for me to wrap my head around
- 
  destroyo123Tue Feb 03 2026 23:00:15 GMT-0700 (Mountain Standard Time)
  @mr_arson#0 that's true
- 
  mr_arsonTue Feb 03 2026 23:00:20 GMT-0700 (Mountain Standard Time)
  especially because mosfets get higher resistance as they heat up
- 
  destroyo123Tue Feb 03 2026 23:00:23 GMT-0700 (Mountain Standard Time)
  oh
- 
  destroyo123Tue Feb 03 2026 23:00:47 GMT-0700 (Mountain Standard Time)
  not great I guess I was originally looking for ones with a 3.3V-compatible gate or whatever it's called
- 
  mr_arsonTue Feb 03 2026 23:00:55 GMT-0700 (Mountain Standard Time)
  yeah and that's a good idea
- 
  mr_arsonTue Feb 03 2026 23:01:00 GMT-0700 (Mountain Standard Time)
  but you can find a logic level fet that will do 5A
- 
  destroyo123Tue Feb 03 2026 23:01:06 GMT-0700 (Mountain Standard Time)
  ultimately was not fortunate so switched to the 2x setup
- 
  destroyo123Tue Feb 03 2026 23:01:11 GMT-0700 (Mountain Standard Time)
  oh?
- 
  destroyo123Tue Feb 03 2026 23:01:19 GMT-0700 (Mountain Standard Time)
  damn I guess I'm looking wrong
- 
  mr_arsonTue Feb 03 2026 23:05:06 GMT-0700 (Mountain Standard Time)
  PJS6412 for example
- 
  mr_arsonTue Feb 03 2026 23:05:09 GMT-0700 (Mountain Standard Time)
  you can also just chain fets
- 
  mr_arsonTue Feb 03 2026 23:05:30 GMT-0700 (Mountain Standard Time)
  a bss128 is basically free and will do 200mA or whatever
- 
  mr_arsonTue Feb 03 2026 23:05:35 GMT-0700 (Mountain Standard Time)
  chain that to drive the bigger fet
- 
  mr_arsonTue Feb 03 2026 23:06:27 GMT-0700 (Mountain Standard Time)
  your boot0 looks fine or at least bodgable. idk if i would wire the ftdi dtr to it but you can also remove that component
- 
  mr_arsonTue Feb 03 2026 23:06:34 GMT-0700 (Mountain Standard Time)
  are you sure it doesn't need to be pulled to gnd
- 
  mr_arsonTue Feb 03 2026 23:06:37 GMT-0700 (Mountain Standard Time)
  (check)
- 
  destroyo123Tue Feb 03 2026 23:06:46 GMT-0700 (Mountain Standard Time)
  @mr_arson#0 like the 3.3V out from the FTDI's regulator?
- 
  destroyo123Tue Feb 03 2026 23:06:55 GMT-0700 (Mountain Standard Time)
  to power it when USB is connected?
- 
  mr_arsonTue Feb 03 2026 23:07:13 GMT-0700 (Mountain Standard Time)
  oh and then you have the ftdi RTS wired to nRST
- 
  mr_arsonTue Feb 03 2026 23:07:14 GMT-0700 (Mountain Standard Time)
  👀
- 
  mr_arsonTue Feb 03 2026 23:07:19 GMT-0700 (Mountain Standard Time)
  im assuming you got that from somewhere?
- 
  destroyo123Tue Feb 03 2026 23:07:34 GMT-0700 (Mountain Standard Time)
  I think I tried to use the FTDI's datasheet alongside the STMs
- 
  destroyo123Tue Feb 03 2026 23:07:55 GMT-0700 (Mountain Standard Time)
  the FTDI had generic recommendations, and then I tried to match them with the STM32's
- 
  mr_arsonTue Feb 03 2026 23:08:11 GMT-0700 (Mountain Standard Time)
  I've never seen someone wire nRST to RTS
- 
  destroyo123Tue Feb 03 2026 23:08:18 GMT-0700 (Mountain Standard Time)
  I think what I did was just UART but I am totally prone to messing this stuff up
- 
  destroyo123Tue Feb 03 2026 23:08:27 GMT-0700 (Mountain Standard Time)
  so probably did
- 
  mr_arsonTue Feb 03 2026 23:08:35 GMT-0700 (Mountain Standard Time)
  that means that when the computer says "I have data I'm ready to send" your chip will restart
- 
  destroyo123Tue Feb 03 2026 23:08:44 GMT-0700 (Mountain Standard Time)
  That actually made me laugh
- 
  mr_arsonTue Feb 03 2026 23:08:52 GMT-0700 (Mountain Standard Time)
  it's cute if you can get the computer software to cooperate and use the RTS pin separately from the UART protocol
- 
  mr_arsonTue Feb 03 2026 23:09:10 GMT-0700 (Mountain Standard Time)
  but I've never seen it before
- 
  mr_arsonTue Feb 03 2026 23:09:14 GMT-0700 (Mountain Standard Time)
  what you do need to pin out is SWD
- 
  mr_arsonTue Feb 03 2026 23:09:47 GMT-0700 (Mountain Standard Time)
  do you have stm32cubemx, if not, install and configure your project through that
- 
  mr_arsonTue Feb 03 2026 23:09:57 GMT-0700 (Mountain Standard Time)
  you should also be using pin functions
- 
  mr_arsonTue Feb 03 2026 23:09:58 GMT-0700 (Mountain Standard Time)
  图片附件
- 
  destroyo123Tue Feb 03 2026 23:10:00 GMT-0700 (Mountain Standard Time)
  ah I was otherwise planning to do platformio
- 
  mr_arsonTue Feb 03 2026 23:10:13 GMT-0700 (Mountain Standard Time)
  that's fine, but I would do pin assignment in cubemx
- 
  destroyo123Tue Feb 03 2026 23:10:16 GMT-0700 (Mountain Standard Time)
  @mr_arson#0 This is a novel concept to me what do they do
- 
  mr_arsonTue Feb 03 2026 23:10:20 GMT-0700 (Mountain Standard Time)
  beacuse not every pin does every thing
- 
  mr_arsonTue Feb 03 2026 23:10:28 GMT-0700 (Mountain Standard Time)
  it just changes the label
- 
  mr_arsonTue Feb 03 2026 23:10:38 GMT-0700 (Mountain Standard Time)
  图片附件
- 
  mr_arsonTue Feb 03 2026 23:10:41 GMT-0700 (Mountain Standard Time)
  so your schematic is readable
- 
  mr_arsonTue Feb 03 2026 23:10:52 GMT-0700 (Mountain Standard Time)
  these are good but you should be using labels not global labels
  图片附件
- 
  mr_arsonTue Feb 03 2026 23:10:57 GMT-0700 (Mountain Standard Time)
  nitpick you wouldn't have known about
- 
  mr_arsonTue Feb 03 2026 23:10:59 GMT-0700 (Mountain Standard Time)
  just press "l"
- 
  destroyo123Tue Feb 03 2026 23:11:06 GMT-0700 (Mountain Standard Time)
  oh
- 
  destroyo123Tue Feb 03 2026 23:11:21 GMT-0700 (Mountain Standard Time)
  do regular labels go across the heirarchical sheets?
- 
  mr_arsonTue Feb 03 2026 23:11:25 GMT-0700 (Mountain Standard Time)
  this is bad. mark as NC (no connect) with the X tool ('q')
  图片附件
- 
  mr_arsonTue Feb 03 2026 23:11:39 GMT-0700 (Mountain Standard Time)
  you shouldn't be using labels across hierarichal sheets, you should be using hierarchical labels
- 
  destroyo123Tue Feb 03 2026 23:11:45 GMT-0700 (Mountain Standard Time)
  oh
- 
  mr_arsonTue Feb 03 2026 23:12:02 GMT-0700 (Mountain Standard Time)
  alternatively you should be using global labels sparingly so that it is clear when they cross sheet boundries
- 
  mr_arsonTue Feb 03 2026 23:12:09 GMT-0700 (Mountain Standard Time)
  either one. but the first is better IMHO
- 
  destroyo123Tue Feb 03 2026 23:12:11 GMT-0700 (Mountain Standard Time)
  @mr_arson#0 what's going on here I thought all the pins were on that diagram
- 
  destroyo123Tue Feb 03 2026 23:12:16 GMT-0700 (Mountain Standard Time)
  it's missing pins isn't it
- 
  mr_arsonTue Feb 03 2026 23:12:22 GMT-0700 (Mountain Standard Time)
  no you're just like
- 
  mr_arsonTue Feb 03 2026 23:12:29 GMT-0700 (Mountain Standard Time)
  the PA11 label doesn't connect to anything
- 
  destroyo123Tue Feb 03 2026 23:12:29 GMT-0700 (Mountain Standard Time)
  ohhhh
- 
  destroyo123Tue Feb 03 2026 23:12:30 GMT-0700 (Mountain Standard Time)
  wait yeah
- 
  destroyo123Tue Feb 03 2026 23:12:31 GMT-0700 (Mountain Standard Time)
  ok ok
- 
  destroyo123Tue Feb 03 2026 23:12:37 GMT-0700 (Mountain Standard Time)
  I understand now
- 
  mr_arsonTue Feb 03 2026 23:12:45 GMT-0700 (Mountain Standard Time)
  图片附件
- 
  mr_arsonTue Feb 03 2026 23:12:50 GMT-0700 (Mountain Standard Time)
  but also you should really hook up SWD
- 
  destroyo123Tue Feb 03 2026 23:13:04 GMT-0700 (Mountain Standard Time)
  so what is that and what does it do
- 
  mr_arsonTue Feb 03 2026 23:13:09 GMT-0700 (Mountain Standard Time)
  lets you actually program it
- 
  mr_arsonTue Feb 03 2026 23:13:11 GMT-0700 (Mountain Standard Time)
  and debug it
- 
  mr_arsonTue Feb 03 2026 23:13:21 GMT-0700 (Mountain Standard Time)
  https://www.st.com/en/development-tools/stlink-v3minie.html this is a nice debugger, find a 3d printed case so you don't short it out
- 
  destroyo123Tue Feb 03 2026 23:13:24 GMT-0700 (Mountain Standard Time)
  neat!
- 
  mr_arsonTue Feb 03 2026 23:13:49 GMT-0700 (Mountain Standard Time)
  there's a samtec connector 2x5 0.1" pitch header you can place on your pcb that is standard that mates with the cable it comes with
- 
  mr_arsonTue Feb 03 2026 23:14:02 GMT-0700 (Mountain Standard Time)
  then when your shit doesn't work you don't have to count how many times the led blinks
- 
  destroyo123Tue Feb 03 2026 23:14:10 GMT-0700 (Mountain Standard Time)
  hey I'll take it
- 
  mr_arsonTue Feb 03 2026 23:14:10 GMT-0700 (Mountain Standard Time)
  ✨ breakpoints
- 
  destroyo123Tue Feb 03 2026 23:14:12 GMT-0700 (Mountain Standard Time)
  that sounds lovely
- 
  mr_arsonTue Feb 03 2026 23:14:19 GMT-0700 (Mountain Standard Time)
  i literally use this debugger at work lmao
- 
  destroyo123Tue Feb 03 2026 23:14:27 GMT-0700 (Mountain Standard Time)
  yes ooh wait where do you work
- 
  mr_arsonTue Feb 03 2026 23:14:49 GMT-0700 (Mountain Standard Time)
  instead of the other debugger i have on my desk which is at least 4 digits iirc
- 
  mr_arsonTue Feb 03 2026 23:14:54 GMT-0700 (Mountain Standard Time)
  for the government ✨
- 
  destroyo123Tue Feb 03 2026 23:15:00 GMT-0700 (Mountain Standard Time)
  fair enough
- 
  mr_arsonTue Feb 03 2026 23:16:03 GMT-0700 (Mountain Standard Time)
  bad
  图片附件
- 
  mr_arsonTue Feb 03 2026 23:16:04 GMT-0700 (Mountain Standard Time)
  图片附件
- 
  mr_arsonTue Feb 03 2026 23:16:05 GMT-0700 (Mountain Standard Time)
  better
- 
  mr_arsonTue Feb 03 2026 23:16:11 GMT-0700 (Mountain Standard Time)
  power should always be up
- 
  destroyo123Tue Feb 03 2026 23:16:20 GMT-0700 (Mountain Standard Time)
  interesting
- 
  mr_arsonTue Feb 03 2026 23:16:28 GMT-0700 (Mountain Standard Time)
  best
  图片附件
- 
  mr_arsonTue Feb 03 2026 23:16:40 GMT-0700 (Mountain Standard Time)
  same with these, gnd should be pointed down
- 
  mr_arsonTue Feb 03 2026 23:16:41 GMT-0700 (Mountain Standard Time)
  图片附件
- 
  destroyo123Tue Feb 03 2026 23:16:52 GMT-0700 (Mountain Standard Time)
  neat
- 
  destroyo123Tue Feb 03 2026 23:16:56 GMT-0700 (Mountain Standard Time)
  the more you know
- 
  mr_arsonTue Feb 03 2026 23:17:28 GMT-0700 (Mountain Standard Time)
  U3/U4 symbols should have the pins relocated so that they're nicer
- 
  mr_arsonTue Feb 03 2026 23:17:38 GMT-0700 (Mountain Standard Time)
  and you should connect every pin or put an ❌ on it
- 
  mr_arsonTue Feb 03 2026 23:17:41 GMT-0700 (Mountain Standard Time)
  so you don't forget
- 
  destroyo123Tue Feb 03 2026 23:17:42 GMT-0700 (Mountain Standard Time)
  roger that
- 
  destroyo123Tue Feb 03 2026 23:18:00 GMT-0700 (Mountain Standard Time)
  not trusting the SnapEDA schematics will help
- 
  mr_arsonTue Feb 03 2026 23:18:22 GMT-0700 (Mountain Standard Time)
  for stuff like this you can actually make n-1 of the pins invisible, this is "standard", kind of silly but it works
  图片附件
- 
  destroyo123Tue Feb 03 2026 23:19:16 GMT-0700 (Mountain Standard Time)
  n-1 being these labels?
- 
  mr_arsonTue Feb 03 2026 23:19:35 GMT-0700 (Mountain Standard Time)
  yeah
- 
  mr_arsonTue Feb 03 2026 23:19:39 GMT-0700 (Mountain Standard Time)
  like leave one visible
- 
  destroyo123Tue Feb 03 2026 23:19:45 GMT-0700 (Mountain Standard Time)
  ah
- 
  mr_arsonTue Feb 03 2026 23:22:12 GMT-0700 (Mountain Standard Time)
  you probably should read the entire datasheet of your adc
- 
  mr_arsonTue Feb 03 2026 23:22:21 GMT-0700 (Mountain Standard Time)
  brief glance you're missing a few important pins
- 
  mr_arsonTue Feb 03 2026 23:22:28 GMT-0700 (Mountain Standard Time)
  CLK included
- 
  destroyo123Tue Feb 03 2026 23:22:48 GMT-0700 (Mountain Standard Time)
  darn alright
- 
  mr_arsonTue Feb 03 2026 23:23:01 GMT-0700 (Mountain Standard Time)
  at least it has legs so you can bodge it to get it to work
- 
  destroyo123Tue Feb 03 2026 23:23:29 GMT-0700 (Mountain Standard Time)
  that one was also a bit of a last-minute change too I was originally looking at one that had better specs for my case, but then realized I had no idea how to hook it to the STM32 so I2C>>
- 
  destroyo123Tue Feb 03 2026 23:23:32 GMT-0700 (Mountain Standard Time)
  yeah
- 
  mr_arsonTue Feb 03 2026 23:24:10 GMT-0700 (Mountain Standard Time)
  external adc is a good idea in general, though frankly the stm32 adc has performed quite well in my limited experience
- 
  destroyo123Tue Feb 03 2026 23:24:16 GMT-0700 (Mountain Standard Time)
  oh no way?
- 
  destroyo123Tue Feb 03 2026 23:24:26 GMT-0700 (Mountain Standard Time)
  I'll be putting 0-5V as the analog
- 
  destroyo123Tue Feb 03 2026 23:24:27 GMT-0700 (Mountain Standard Time)
  though
- 
  mr_arsonTue Feb 03 2026 23:24:33 GMT-0700 (Mountain Standard Time)
  voltage divider /shrug
- 
  destroyo123Tue Feb 03 2026 23:24:37 GMT-0700 (Mountain Standard Time)
  yeah fair
- 
  mr_arsonTue Feb 03 2026 23:24:42 GMT-0700 (Mountain Standard Time)
  resistors are free
- 
  mr_arsonTue Feb 03 2026 23:25:24 GMT-0700 (Mountain Standard Time)
  i would say you should target at least 0805 but your ICs are harder to solder than 0603s so
- 
  destroyo123Tue Feb 03 2026 23:26:16 GMT-0700 (Mountain Standard Time)
  also noted
- 
  mr_arsonTue Feb 03 2026 23:27:06 GMT-0700 (Mountain Standard Time)
  when i was in highschool i did some 0805 soldering with chris
- 
  mr_arsonTue Feb 03 2026 23:27:16 GMT-0700 (Mountain Standard Time)
  maybe midlde school actually?
- 
  erzerumTue Feb 03 2026 23:27:23 GMT-0700 (Mountain Standard Time)
  i remember this
- 
  mr_arsonTue Feb 03 2026 23:27:25 GMT-0700 (Mountain Standard Time)
  had an insane skill issue tho but i got it to work
- 
  mr_arsonTue Feb 03 2026 23:27:40 GMT-0700 (Mountain Standard Time)
  图片附件
- 
  mr_arsonTue Feb 03 2026 23:27:44 GMT-0700 (Mountain Standard Time)
  10th grade
- 
  erzerumTue Feb 03 2026 23:27:50 GMT-0700 (Mountain Standard Time)
  my hands were not steady enough for this
- 
  mr_arsonTue Feb 03 2026 23:28:17 GMT-0700 (Mountain Standard Time)
  in college I probably placed 2000 0402s and soldered another couple hundred by hand
- 
  destroyo123Tue Feb 03 2026 23:28:22 GMT-0700 (Mountain Standard Time)
  that looks fun
- 
  mr_arsonTue Feb 03 2026 23:28:38 GMT-0700 (Mountain Standard Time)
  they're pretty easy once you figure the tricks out. and have a soldering iron from this decade
- 
  destroyo123Tue Feb 03 2026 23:28:44 GMT-0700 (Mountain Standard Time)
  yeah I bet
- 
  destroyo123Tue Feb 03 2026 23:29:02 GMT-0700 (Mountain Standard Time)
  there are some really nice ones at our makerspace on campus we have a worse one in the club room
- 
  destroyo123Tue Feb 03 2026 23:29:10 GMT-0700 (Mountain Standard Time)
  there're some mectal ones that are so so so nice
- 
  destroyo123Tue Feb 03 2026 23:29:21 GMT-0700 (Mountain Standard Time)
  like $900/pop (not the club one)
- 
  mr_arsonTue Feb 03 2026 23:29:28 GMT-0700 (Mountain Standard Time)
  i bet the tips are fucked up
- 
  destroyo123Tue Feb 03 2026 23:29:36 GMT-0700 (Mountain Standard Time)
  they are still ok because not too many people use them
- 
  destroyo123Tue Feb 03 2026 23:29:40 GMT-0700 (Mountain Standard Time)
  it's still a newer facility
- 
  mr_arsonTue Feb 03 2026 23:29:44 GMT-0700 (Mountain Standard Time)
  but yeah metcal is The Best in the world
- 
  destroyo123Tue Feb 03 2026 23:29:48 GMT-0700 (Mountain Standard Time)
  augh
- 
  mr_arsonTue Feb 03 2026 23:30:19 GMT-0700 (Mountain Standard Time)
  jbc gets close but they start at more like $1500 and have a cheaper tip selection (only like $70 a tip) but you get temperature control
- 
  mr_arsonTue Feb 03 2026 23:30:25 GMT-0700 (Mountain Standard Time)
  everything else is left in the dust
- 
  mr_arsonTue Feb 03 2026 23:30:28 GMT-0700 (Mountain Standard Time)
  then there's pinecils
- 
  mr_arsonTue Feb 03 2026 23:30:37 GMT-0700 (Mountain Standard Time)
  that's about all that is worth thinking about TBH
- 
  mr_arsonTue Feb 03 2026 23:30:47 GMT-0700 (Mountain Standard Time)
  the club i ran had a jbc
- 
  destroyo123Tue Feb 03 2026 23:31:06 GMT-0700 (Mountain Standard Time)
  that looks nice
- 
  destroyo123Tue Feb 03 2026 23:32:11 GMT-0700 (Mountain Standard Time)
  unfortunately unlike a lot of electrical-orientied individuals I am gonna go to sleep soon but this feedback is so huge thank you so much
- 
  mr_arsonTue Feb 03 2026 23:32:36 GMT-0700 (Mountain Standard Time)
  you should make sure these aren't swapped
  图片附件
- 
  mr_arsonTue Feb 03 2026 23:32:39 GMT-0700 (Mountain Standard Time)
  yeah absolutely
- 
  destroyo123Tue Feb 03 2026 23:33:00 GMT-0700 (Mountain Standard Time)
  hopefully not too much trouble
- 
  mr_arsonTue Feb 03 2026 23:33:17 GMT-0700 (Mountain Standard Time)
  I bill 150/hr so i want whatever $300 of sponsorship money gets you in terms of sponsor benefits 😛
- 
  destroyo123Tue Feb 03 2026 23:33:32 GMT-0700 (Mountain Standard Time)
  chat is this legit
- 
  erzerumTue Feb 03 2026 23:33:49 GMT-0700 (Mountain Standard Time)
  i cant believe 2 hours went by on this and here i was just listening to organ music the whole time
- 
  mr_arsonTue Feb 03 2026 23:33:54 GMT-0700 (Mountain Standard Time)
  yes
- 
  destroyo123Tue Feb 03 2026 23:33:56 GMT-0700 (Mountain Standard Time)
  was this actually 2 hours
- 
  destroyo123Tue Feb 03 2026 23:33:58 GMT-0700 (Mountain Standard Time)
  oh my goodness
- 
  mr_arsonTue Feb 03 2026 23:34:12 GMT-0700 (Mountain Standard Time)
  oh and this is not impedance matched
- 
  mr_arsonTue Feb 03 2026 23:34:13 GMT-0700 (Mountain Standard Time)
  图片附件
- 
  mr_arsonTue Feb 03 2026 23:34:22 GMT-0700 (Mountain Standard Time)
  jlcpcb has a calculator, just follow that
- 
  mr_arsonTue Feb 03 2026 23:34:25 GMT-0700 (Mountain Standard Time)
  50 ohms or w/e
- 
  destroyo123Tue Feb 03 2026 23:34:30 GMT-0700 (Mountain Standard Time)
  JLC's calculator?
- 
  mr_arsonTue Feb 03 2026 23:34:40 GMT-0700 (Mountain Standard Time)
  .https://jlcpcb.com/pcb-impedance-calculator
- 
  destroyo123Tue Feb 03 2026 23:34:43 GMT-0700 (Mountain Standard Time)
  so do I just set the ah
- 
  mr_arsonTue Feb 03 2026 23:34:46 GMT-0700 (Mountain Standard Time)
  just the default 2L
- 
  destroyo123Tue Feb 03 2026 23:34:58 GMT-0700 (Mountain Standard Time)
  okey dokey
- 
  mr_arsonTue Feb 03 2026 23:34:58 GMT-0700 (Mountain Standard Time)
  they only have one
- 
  mr_arsonTue Feb 03 2026 23:35:30 GMT-0700 (Mountain Standard Time)
  and i would also pick ICs with legs so you can bodge them easier
- 
  mr_arsonTue Feb 03 2026 23:35:33 GMT-0700 (Mountain Standard Time)
  other than that pretty reasonable
- 
  mr_arsonTue Feb 03 2026 23:35:39 GMT-0700 (Mountain Standard Time)
  good luck with everything
- 
  destroyo123Tue Feb 03 2026 23:35:44 GMT-0700 (Mountain Standard Time)
  thank you again
- 
  mr_arsonTue Feb 03 2026 23:35:54 GMT-0700 (Mountain Standard Time)
  happy to help
- 
  mr_arsonTue Feb 03 2026 23:35:59 GMT-0700 (Mountain Standard Time)
  don't do enough electrical engineering these days
- 
  destroyo123Tue Feb 03 2026 23:35:59 GMT-0700 (Mountain Standard Time)
  I'll make this into a list of action items or something
- 
  destroyo123Tue Feb 03 2026 23:36:08 GMT-0700 (Mountain Standard Time)
  I do nothing but these days
- 
  mr_arsonTue Feb 03 2026 23:36:17 GMT-0700 (Mountain Standard Time)
  it's kind of good isn't it
- 
  destroyo123Tue Feb 03 2026 23:36:31 GMT-0700 (Mountain Standard Time)
  basically just applying to avionics / embedded systems work at this point
- 
  destroyo123Tue Feb 03 2026 23:36:35 GMT-0700 (Mountain Standard Time)
  @mr_arson#0 I do enjoy it
- 
  destroyo123Tue Feb 03 2026 23:36:46 GMT-0700 (Mountain Standard Time)
  as much pain as it is to read datasheets the rest is quite fun
