Wildcat-Rocket-Engineering-Club/WRECtangle/Misc/AnalogSignalMeasureCalculator/ADS1255-7 Calculator.xlsx

Sheet: Table of Contents
Worksheets | Description
Register Map | Lists the ADS1255, ADS1256, and ADS1257 register map fields, descriptions, and the corresponding read/write commands.
ADC Input Range | Calculates if an applied input signal will satisfy the absolute and differential input range requirements.
Calibration | Calculations for offset and gain error calibration coefficients.
Digital Filter | Calculates the SINC filter frequency response.
Code Conversions | Converts ADC raw codes to corresponding voltages
Noise Table | Lookup table for ADC input referred noise.
About | Information about this tool.
Help | How to use this tool.

Sheet: Register Map
 |  |  |  |  |  |  |  |  |  |  |  |  | Table of Contents
Show Register Map for: |  |  |  | ADS1255 |  | ← Select a device
 |  |  |  |  |  |  | Configure register settings
Address (Hex) | Register Name | Read/Write | Default (Hex) | Bit # |  |  |  |  |  |  |  | Value | Read Command | Write Command
 |  |  |  | 7 | 6 | 5 | 4 | 3 | 2 | 1 | 0
0x00 | STATUS | R/W | x1 | ID[3] | ID[2] | ID[1] | ID[0] | ORDER | ACAL | BUFEN | DRDY | 0x31 | 10h, 00h, 00h | 50h, 00h, 31h
 |  |  |  | 0 | 0 | 1 | 1 | 0 | 0 | 0 | 1
 |  |  |  |  |  |  |  | MSb First | ACAL Disabled | BUF Disabled | /DRDY High
0x01 | MUX | R/W | 01 | PSEL[3] | PSEL[2] | PSEL[1] | PSEL[0] | NSEL[3] | NSEL[2] | NSEL[1] | NSEL[2] | 0x01 | 11h, 00h, 00h | 51h, 00h, 01h
 |  |  |  | 0 | 0 | 0 | 0 | 0 | 0 | 0 | 1
 |  |  |  | AIN0 |  |  |  | AIN1
0x02 | ADCON | R/W | 20 | ---- | CLK[1] | CLK[0] | SDCS[1] | SDCS[0] | PGA[2] | PGA[1] | PGA[0] | 0x20 | 12h, 00h, 00h | 52h, 00h, 20h
 |  |  |  | 0 | 0 | 1 | 0 | 0 | 0 | 0 | 0
 |  |  |  | Reserved | CLKOUT = fCLKIN |  | Sensor Detect OFF |  | PGA Gain = 1 V/V
0x03 | DRATE | R/W | F0 | DR[7] | DR[6] | DR[5] | DR[4] | DR[3] | DR[2] | DR[1] | DR[0] | 0xF0 | 13h, 00h, 00h | 53h, 00h, F0h
 |  |  |  | 1 | 1 | 1 | 1 | 0 | 0 | 0 | 0
 |  |  |  | Data Rate = 30000 SPS
0x04 | IO | R/W | E0 | DIR[3] (1) | DIR[2] (1) | DIR[1] | DIR[0] | DIO[3] (1) | DIO[2] (1) | DIO[1] | DIO[0] (2) | 0xE0 | 14h, 00h, 00h | 54h, 00h, E0h
 |  |  |  | 1 | 1 | 1 | 0 | 0 | 0 | 0 | 0
 |  |  |  | D3 = Input | D2 = Input | D1 = Input | D0/CLK = Output | D3 = Low | D2 = Low | D1 = Low | D0 = Low
OFC[2:0] and FSC[2:0] Register values are programmed on the "Calibration" tab…
0x05 | OFC0 | R/W | xx | OFC[7] | OFC[6] | OFC[5] | OFC[4] | OFC[3] | OFC[2] | OFC[1] | OFC[0] | 0x00 | 15h, 00h, 00h | 55h, 00h, 00h
 |  |  |  | 0 | 0 | 0 | 0 | 0 | 0 | 0 | 0
0x06 | OFC1 | R/W | xx | OFC[15] | OFC[14] | OFC[13] | OFC[12] | OFC[11] | OFC[10] | OFC[9] | OFC[8] | 0x00 | 16h, 00h, 00h | 56h, 00h, 00h
 |  |  |  | 0 | 0 | 0 | 0 | 0 | 0 | 0 | 0
0x07 | OFC2 | R/W | xx | OFC[23] | OFC[22] | OFC[21] | OFC[20] | OFC[19] | OFC[18] | OFC[17] | OFC[16] | 0x00 | 17h, 00h, 00h | 57h, 00h, 00h
 |  |  |  | 0 | 0 | 0 | 0 | 0 | 0 | 0 | 0
0x08 | FSC0 | R/W | xx | FSC[7] | FSC[6] | FSC[5] | FSC[4] | FSC[3] | FSC[2] | FSC[1] | FSC[0] | 0x08 | 18h, 00h, 00h | 58h, 00h, 08h
 |  |  |  | 0 | 0 | 0 | 0 | 1 | 0 | 0 | 0
0x09 | FSC1 | R/W | xx | FSC[15] | FSC[14] | FSC[13] | FSC[12] | FSC[11] | FSC[10] | FSC[9] | FSC[8] | 0xAC | 19h, 00h, 00h | 59h, 00h, ACh
 |  |  |  | 1 | 0 | 1 | 0 | 1 | 1 | 0 | 0
0x0A | FSC2 | R/W | xx | FSC[23] | FSC[22] | FSC[21] | FSC[20] | FSC[19] | FSC[18] | FSC[17] | FSC[16] | 0x44 | 1Ah, 00h, 00h | 5Ah, 00h, 44h
 |  |  |  | 0 | 1 | 0 | 0 | 0 | 1 | 0 | 0
Notes:
(1) When using an ADS1255 or ADS1257, the register bits DIR3, DIR2, DIO3, and DIO2 can be read from and written to, but have no effect. |  |  |  |  |  |  |  |  |  |  |  |  |  | Legend
(2) When DO/CLKOUT is configured as an output and CLKOUT is enabled (using CLK[1:0] bits in the ADCON register), writing to DIO0 has no effect. |  |  |  |  |  |  |  |  |  |  |  |  | Input = | #
 |  |  |  |  |  |  |  |  |  |  |  |  | Result = | #
 |  |  |  |  |  |  |  |  |  |  |  |  | Static Value = | #
 |  |  |  |  |  |  |  |  |  |  |  |  | Logic High = | #
 |  |  |  |  |  |  |  |  |  |  |  |  | Logic Low = | #
 |  |  |  |  |  |  |  |  |  |  |  |  | Non-Default = | #

Sheet: ADC Input Range
 |  |  |  |  |  |  |  |  |  |  |  |  |  | Table of Contents
 | ↓ Configure ADC Parameters |  |  | ↓ Define Input Voltages
 | PGA Gain & Buffer |  |  | Input Voltage |  |  |  |  |  |  |  |  |  | Legend
 | PGA Gain | 1 | V/V | VINP | 3 | V |  | ← Positive input is outside the absolute input range! |  |  |  |  | Input = | #
 | Buffer | OFF |  | VINN | 2 | V |  | ← Negative input is outside the absolute input range! |  |  |  |  | Result = | #
 |  |  |  | VDIFF | 1 | V |  | ← Input exceeds the differential input range! |  |  |  |  | Invalid Parameter = | #
 | Supply Voltage
 | AVDD | 5 | V
 | AGND | 0 | V
 | Reference Voltage(s)
 | VREFP | 2.5 | V
 | VREFN | 0 | V
 |  |  |  |  |  |  |  |  | ±5 V
 |  |  |  |  |  |  |  |  |  | -0.1 - 5.1 V
↓ Calculations ↓
 |  |  |  | Horizontal Lines |  |  |  |  |  | Vertical Lines
 |  |  |  | X | AGND | AVDD | VINN | VINP |  | Absolute Input Voltage Range
 |  |  |  | 0.1 |  |  | 2 | 3 |  |  | INP/N_UPPER_LIMIT = | 5.1
 |  |  |  | 1 |  |  | 2 | 3 |  |  | INP/N_LOWER_LIMIT = | -0.1
 |  |  |  | 0.5 | 0 | 5
 |  |  |  | 1.5 | 0 | 5 |  |  |  | Differential Input Voltage Range
 |  |  |  |  |  |  |  |  |  |  | VDIFF_UPPER_LIMIT = | 5
 |  |  |  |  |  |  |  |  |  |  | VDIFF_LOWER_LIMIT = | -5.000
 |  |  |  |  |  |  |  |  |  | Diff I/p | 0.45 | 3
 |  |  |  |  |  |  |  |  |  |  | 0.45 | 2
 |  |  |  |  |  |  |  |  |  | Abs Rng | 2.2 | -0.1
 |  |  |  |  |  |  |  |  |  |  | 2.2 | 5.1
 |  |  |  |  |  |  |  |  |  | Diff Rng | 1.4 | 5
 |  |  |  |  |  |  |  |  |  |  | 1.4 | 0
 |  |  |  |  |  |  |  |  |  |  | Vcm | 2.5
 |  |  |  |  |  |  |  |  |  |  | Vdiff/2 | 2.5
 |  |  |  |  |  |  |  |  |  |  | +Vdiff | 5
 |  |  |  |  |  |  |  |  |  |  | -Vdiff | 0
 |  |  |  |  |  |  |  |  |  |  | In ABS? | TRUE
 |  |  |  |  |  |  |  |  |  |  | Direction | N/A
 |  |  |  |  |  |  |  |  |  |  | Shift (Sub) | 0

Sheet: Calibration
 |  |  |  |  |  |  |  |  |  |  |  | Table of Contents
 | ADC Parameters |  |  |  | Values from Register Map
 | Data Rate | 30000 | [SPS] | ← | DRATE[7:0] | 30000 | [SPS] | ← NOTE: Calibration coefficients scale with the configured data rate!
 | PGA Gain | 1 | [V/V] |  | PGA[2:0] | 1 | [V/V]
 | Reference Voltage | 2.5 | [V]
 | LSb Size | 596.046 | [nV] | ← The LSb size is used to convert the offset calibration coefficient to a voltage
 | Calibration Coefficents (24-bit) |  |  | → | Offset Voltage and Gain Error Scaling
 | OFC[2:0] | 000000 | [Hex] |  | Offset Voltage RTI (1) | 0.000000 | [V] | ← Significance of OFCAL and FSCAL register values
 | FSC[2:0] | 44AC08 | [Hex] |  | Gain Correction Factor | 1.000000 | [V/V]
 | The nominal FSC [2:0] value for data rate = 30000 SPS is 44AC08h
 | Offset Voltage and Gain Error Scaling |  |  | → | Calibration Coefficents (24-bit)
 | Offset Voltage (RTI) (1) | 0.000000 | [μV] |  | OFCAL[2:0] | 000000 | [Hex] | ← Calibration coefficients required to correct for indicated offset and gain errors
 | Gain Correction Factor | 1.000000 | [V/V] |  | FSCAL[2:0] | 44AC08 | [Hex]
 | Notes:
 | (1) "RTI" means "referred to input" (i.e. the effective offset voltage seen at the ADC inputs, prior to the PGA)
↓ Look Up Table & Calculations ↓
 | Calibration Values for Different Data Rate Settings (See Data Sheet Table 18)
 | DRATE[7:0] | Data Rate | α |  | β | IDEAL FSC (Hex)
 | 03 | 2.5 | 5DC000 |  | 2.730371587 | 2EE14C
 | 13 | 5 | 5DC000 |  | 2.730371587 | 2EE14C
 | 23 | 10 | 5DC000 |  | 2.730371587 | 2EE14C
 | 33 | 15 | 3E8000 |  | 1.82024733 | 4651F3 |  |  | Coefficient Conversion |  | Voltage Conversion
 | 43 | 25 | 4B0000 |  | 2.18429670 | 3A99A0 |  |  | α | 400000 | Selected Units | [μV]
 | 53 | 30 | 3E8000 |  | 1.82024733 | 4651F3 |  |  | β | 1.863932978 | Offset Voltage [V] | 0
 | 63 | 50 | 4B0000 |  | 2.18429670 | 3A99A0 |  |  | # Bits | 24 | # of Hex Digits | 6
 | 72 | 60 | 3E8000 |  | 1.82024733 | 4651F3 |  |  | Is Negative? | FALSE | OFC[2:0] | 000000
 | 82 | 100 | 4B0000 |  | 2.18429670 | 3A99A0 |  |  | OFC Decimal | 0 | FSC[2:0] | 44AC08
 | 92 | 500 | 3C0000 |  | 1.747437361 | 494008 |  |  | FSC Decimal | 4500488
 | A1 | 1000 | 3C0000 |  | 1.747437361 | 494008 |  |  | OFC/a | 0.00
 | B0 | 2000 | 3C0000 |  | 1.747437361 | 494008 |  |  | FSC*b | 8388608 | Units | Multiplier
 | C0 | 3750 | 400000 |  | 1.863932978 | 44AC08 |  |  | Offset RTI [V] | 0 | [V] | 1
 | D0 | 7500 | 400000 |  | 1.863932978 | 44AC08 |  |  | Selected Units | [V] | [mV] | 0.001
 | E0 | 15000 | 400000 |  | 1.863932978 | 44AC08 |  |  | Offset RTI [V] | 0 | [μV] | 1e-06
 | F0 | 30000 | 400000 |  | 1.863932978 | 44AC08 |  |  |  |  | [nV] | 1e-09
 |  |  |  |  |  |  |  |  | Register Map Values
 |  |  |  |  |  |  |  |  | OFC[0] | 00
 |  |  |  |  |  |  |  |  | OFC[1] | 00
 |  |  |  |  |  |  |  |  | OFC[2] | 00
 |  |  |  |  |  |  |  |  | FSC[0] | 08
 |  |  |  |  |  |  |  |  | FSC[1] | AC
 |  |  |  |  |  |  |  |  | FSC[2] | 44

Sheet: Digital Filter
 |  |  |  |  |  |  |  |  |  |  |  |  | Table of Contents
 | Legend
 | # | = Input
 | # | = Result
 | Select SINC Filter to Graph
 | Value from Register Map: |  | DRATE[7:0] | 30000
 | Data Rate (SPS) |  | 60
 | Time to 1st Conversion (t18) |  | 16.85 | ms
 | SINC Filter Options
 | Clock Frequency, fCLK |  | 7.6800 MHz
 | DR[7:0] Register Bits | Data Rate (SPS) | 1st Stage Decimation | 2nd Stage Decimation
 | 0x03 | 2.50 | 64 | 12000
 | 0x13 | 5.00 | 64 | 6000
 | 0x23 | 10.00 | 64 | 3000
 | 0x33 | 15.00 | 64 | 2000
 | 0x43 | 25.00 | 64 | 1200
 | 0x53 | 30.00 | 64 | 1000
 | 0x63 | 50.00 | 64 | 600
 | 0x72 | 60.00 | 64 | 500
 | 0x82 | 100.00 | 64 | 300
 | 0x92 | 500.00 | 64 | 60
 | 0xA1 | 1000.00 | 64 | 30
 | 0xB0 | 2000.00 | 64 | 15
 | 0xC0 | 3750.00 | 64 | 8
 | 0xD0 | 7500.00 | 64 | 4
 | 0xE0 | 15000.00 | 64 | 2
 | 0xF0 | 30000.00 | 64 | 1
 | -3dB Cutoff Frequency |  | 26.50 | Hz
 | Effective Noise Bandwidth |  | 29.85 | Hz
 | Normal Mode Rejection
 | Frequency (Hz) |  | 60
 | Tolerance (±Δ Hz) |  | 1
 | Minimum Attenuation |  | -34.90 dB
 | (59-61.1 Hz)
 |  |  |  |  |  | Digital Filter Block Diagram
↓ Calculations ↓
MOD CLK DIV |  | Freq (Hz) | Freq (kHz) | H_Stage1(f) | H_Stage2(f) | H_Product(f) | dB | Effective Filter Bandwidth (Hz) |  |  | 29.8
4 |  | 0.1 | 0.0001 | 1.000 | 1.000 | 1.000 | -3.968877044e-05 | Δf (Hz) | Ave response | Area
 |  | 0.2 | 0.0002 | 1.000 | 1.000 | 1.000 | -0.000158755517 | 0.100 | 1.000 | 0.100
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
 |  | 470.0 | 0.5 | 0.998 | 0.020 | 0.020 | -33.857 | 1.000 | 0.0004500339448 | 0.0004500339448
 |  | 471.0 | 0.5 | 0.998 | 0.018 | 0.018 | -34.714 | 1.000 | 0.000373724736 | 0.000373724736
 |  | 472.0 | 0.5 | 0.998 | 0.016 | 0.016 | -35.687 | 1.000 | 0.0003029358615 | 0.0003029358615

Sheet: Code Conversions
 |  |  |  |  |  |  |  |  |  |  | Table of Contents
 | ADC Parameters |  |  |  | Value from Register Map |  |  |  |  |  | Legend
 | PGA Gain | 1 | [V/V] | ← | PGA[2:0] | 1 | [V/V] |  |  | Input = | #
 | Reference Voltage | 2.5 | [V] |  |  |  |  |  |  | Result = | #
 | ↓
 | ADC Input Range & Least Significant Bit (LSB) Size
 | Input Range | +/-5.00 | [V]
 | LSB size | 596.046 | [nV]
 | ADC Output Code (2's Compliment) |  |  |  | Input Voltage RTI (1)
 | 200000 |  | [Hex] | → | 1.250000000 |  | [V]
 | Input a hex value between 0x800000 and 0x7FFFFF
 | Differential Input Voltage RTI (1) |  |  |  | Ideal Output Code (2)
 | 1.250000000 |  | [V] | → | 200000 |  | [Hex]
 |  |  |  |  | Output Code Clipped!
 | Notes:
 | (1) "RTI" means "referred to input" (i.e. the voltage applied to the input pins, prior to the PGA gain)
 | (2) Ideal code ignoring the effects of noise, INL, etc.. (No calibration correction applied!)
↓ Calculations ↓
 | Code: | 200000 |  |  | Code Conversion |  |  | Units | Multiplier
 | Input Type: | [Hex] |  |  | Selected Units: | [V] |  | [V] | 1
 |  |  |  |  | Voltage [V]: | 1.25 |  | [mV] | 0.001
 | Code Validation |  |  |  | Voltage Out-of-Range? | FALSE |  | [μV] | 1e-06
 | Number of Bits: | 24 |  |  | Out-of-Range Direction: | - |  | [nV] | 1e-09
 | Number of hex digits: | 6 |  |  | Decimal: | 2097152
 | Min Code: | -8388608 | 800000 |  | Hex: | 200000
 | Max Code: | 8388607 | 7FFFFF |  | Output Type: | [Hex]
 | Is Number? | TRUE |  |  | Output Code: | 200000
 | In Range? | TRUE
 | Valid? | TRUE
 | Voltage Conversion
 | Is Negative? | FALSE
 | Decimal Value: | 2097152
 | Voltage [V]: | 1.25
 | Selected Units: | [V]
 | Voltage in [V]: | 1.25

Sheet: Help
For any futher assistance on this tool, please post your question in the following forum Room - E2E Precision Data Converters Forum (http://e2e.ti.com/support/data_converters/precision_data_converters/) |  |  |  | Table of Contents
Getting Started with this tool ?
 | 1. Reference the product datasheet, found at the URLs below, for information about the particular device.
 |  | ADS1255: | http://www.ti.com/lit/gpn/ads1255
 |  | ADS1256: | http://www.ti.com/lit/gpn/ads1256
 |  | ADS1257: | http://www.ti.com/lit/gpn/ads1257
 | 2. Go to the Table of Contents for tool descriptions and links to specific worksheets.
 |  | Link: | Table of Contents
 | 3.Use the "Legend" on each worksheet for guidance. The required inputs and calculated results typically follow the convention below:
 |  | # | = Input
 |  | # | = Result
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
