Wildcat-Rocket-Engineering-Club/WRECtangle/Designs/KiCAD Files/Custom Chip Files/models/BNO085.step

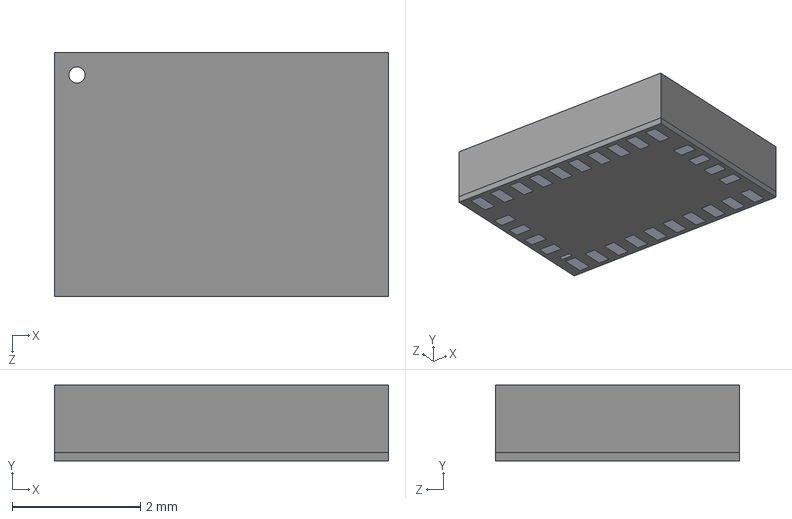
[picture p1: CAD file, 2026-02-22]
Designs/KiCAD Files/Custom Chip Files/models/BNO085.step
5.20 x 1.18 x 3.80 mm
