Wildcat-Rocket-Engineering-Club/WRECtangle/Designs/KiCAD Files/Custom Chip Files/models/MAX-M10S-00B.step

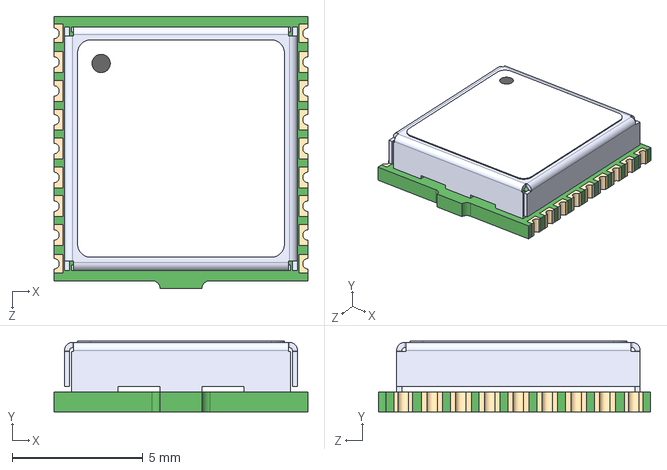
[picture p2: CAD file, 2026-02-22]
Designs/KiCAD Files/Custom Chip Files/models/MAX-M10S-00B.step
9.70 x 2.70 x 10.4 mm
