Wildcat-Rocket-Engineering-Club/WRECtangle/Designs/KiCAD Files/Custom Chip Files/models/BME280.step

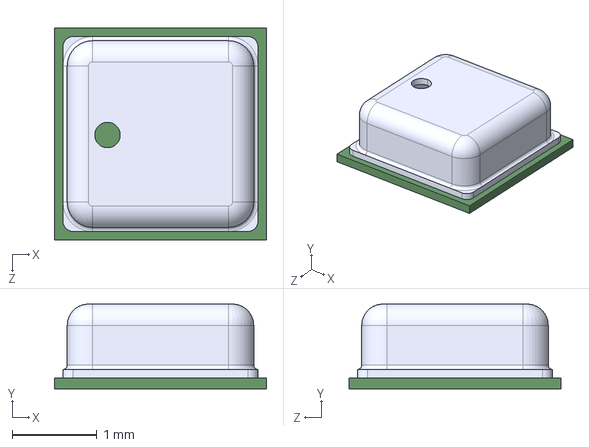
[picture p3: CAD file, 2026-02-22]
Designs/KiCAD Files/Custom Chip Files/models/BME280.step
2.50 x 1.00 x 2.50 mm
