Wildcat-Rocket-Engineering-Club/WRECtangle/Designs/KiCAD Files/Custom Chip Files/models/SMA-Connector.stp

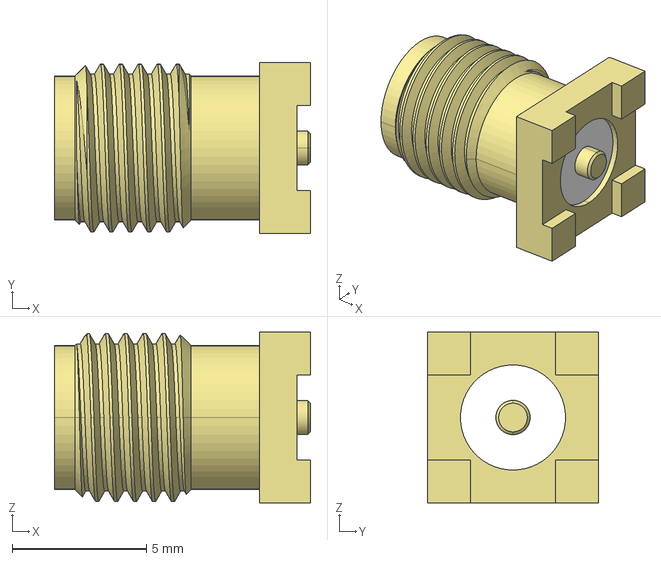
[picture p4: CAD file, 2026-02-22]
Designs/KiCAD Files/Custom Chip Files/models/SMA-Connector.stp
9.53 x 6.35 x 6.35 mm
