Wildcat-Rocket-Engineering-Club/WRECtangle/Designs/KiCAD Files/Custom Chip Files/models/XBP9X-DMUS-001.step

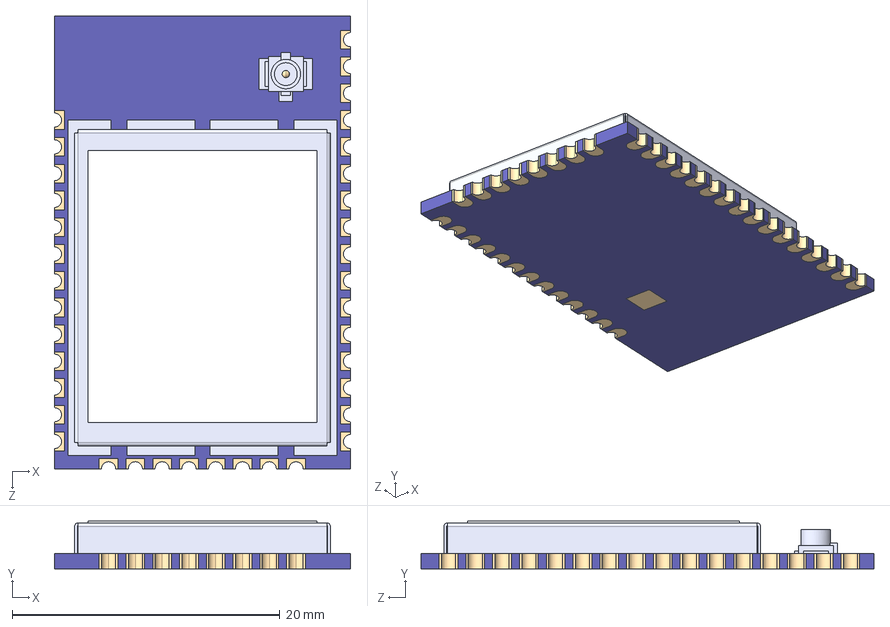
[picture p5: CAD file, 2026-02-22]
Designs/KiCAD Files/Custom Chip Files/models/XBP9X-DMUS-001.step
22.1 x 3.56 x 33.8 mm
