Wildcat-Rocket-Engineering-Club/WRECtangle/Designs/KiCAD Files/Custom Chip Files/models/LTC2344CUH-16_PBF.step

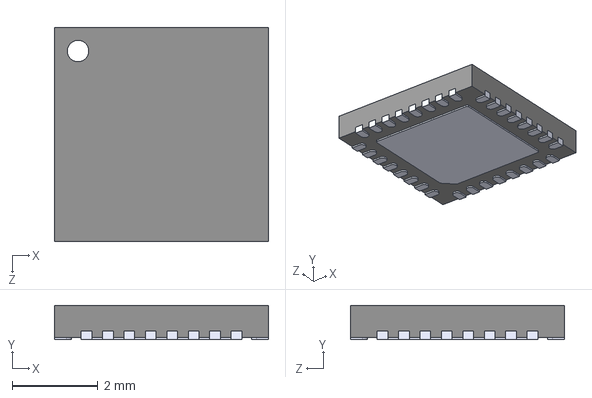
[picture p6: CAD file, 2026-02-22]
Designs/KiCAD Files/Custom Chip Files/models/LTC2344CUH-16_PBF.step
5.00 x 0.8 x 5.00 mm
