Wildcat-Rocket-Engineering-Club/WRECtangle/Designs/KiCAD Files/Custom Chip Files/models/H3LIS331DLTR.step

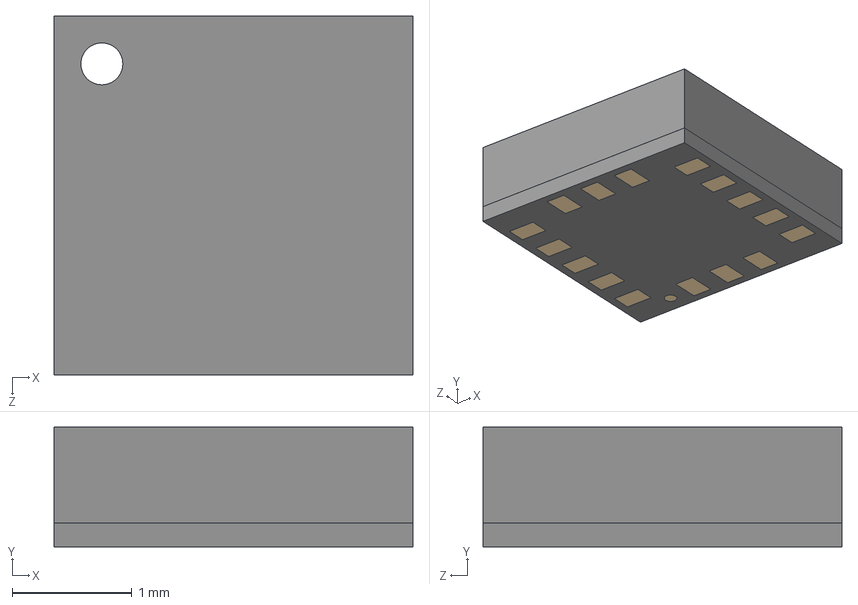
[picture p7: CAD file, 2026-02-22]
Designs/KiCAD Files/Custom Chip Files/models/H3LIS331DLTR.step
3.00 x 1.00 x 3.00 mm
