Wildcat-Rocket-Engineering-Club/WRECtangle/Designs/KiCAD Files/Custom Chip Files/models/STM32F405RGT6.step

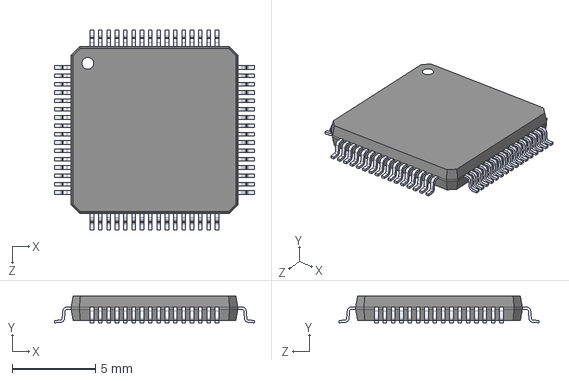
[picture p8: CAD file, 2026-02-22]
Designs/KiCAD Files/Custom Chip Files/models/STM32F405RGT6.step
12.0 x 1.60 x 12.0 mm
