Wildcat-Rocket-Engineering-Club/WRECtangle/Designs/KiCAD Files/Custom Chip Files/models/TPS43060RTER.step

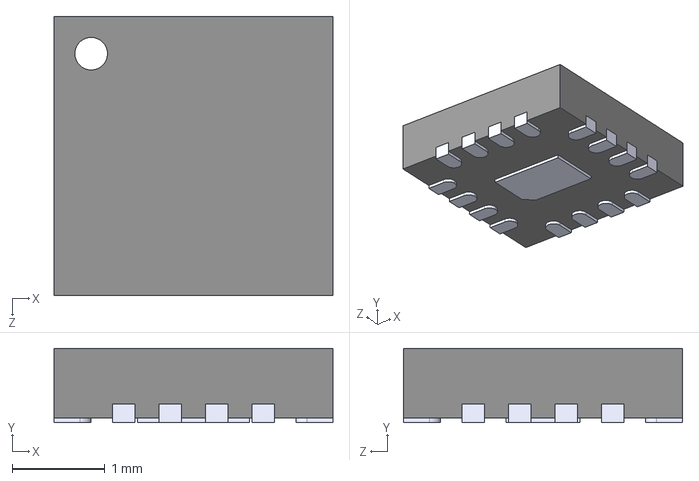
[picture p9: CAD file, 2026-02-22]
Designs/KiCAD Files/Custom Chip Files/models/TPS43060RTER.step
3.00 x 0.8 x 3.00 mm
