Wildcat-Rocket-Engineering-Club/WRECtangle/Designs/KiCAD Files/Custom Chip Files/models/TPS55289RYQR.step

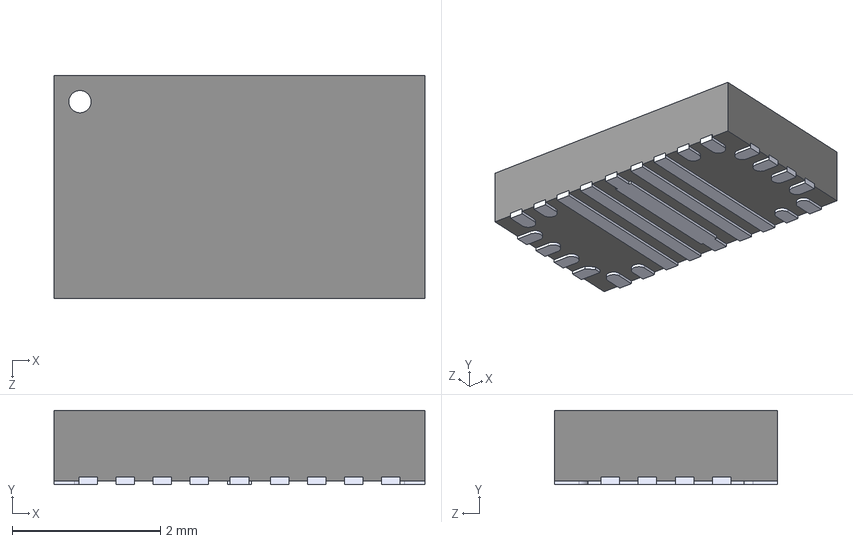
[picture p10: CAD file, 2026-02-22]
Designs/KiCAD Files/Custom Chip Files/models/TPS55289RYQR.step
5.00 x 1.00 x 3.00 mm
