Wildcat-Rocket-Engineering-Club/WRECtangle/Designs/KiCAD Files/Custom Chip Files/models/1x2-ScrewTerminal.step

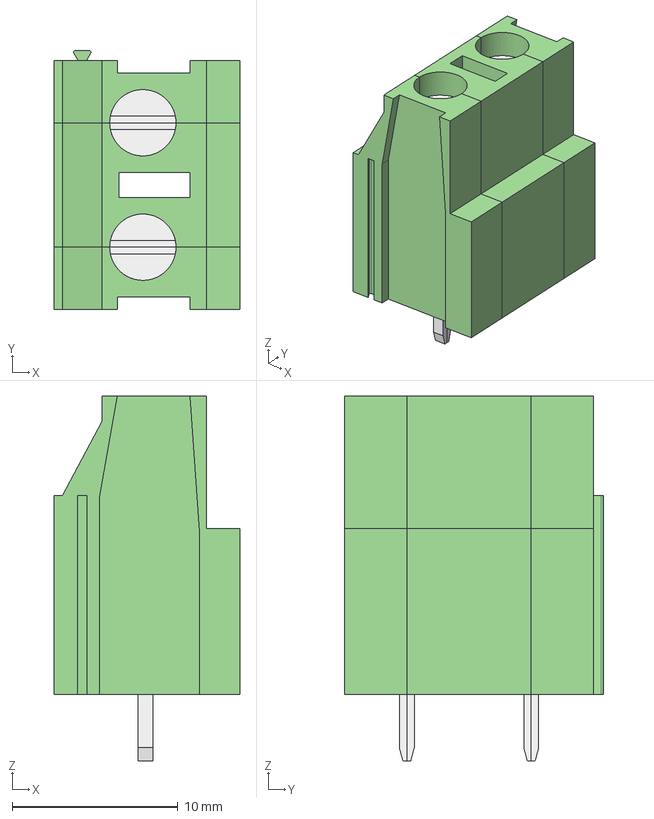
[picture p11: CAD file, 2026-02-22]
Designs/KiCAD Files/Custom Chip Files/models/1x2-ScrewTerminal.step
11.2 x 15.6 x 22.0 mm
MRT5P7.5_SX
MRT5P7.5_CNT
MRT5P7.5_DX
