Wildcat-Rocket-Engineering-Club/WRECtangle/Designs/KiCAD Files/Custom Chip Files/models/TPS56637RPAR.step

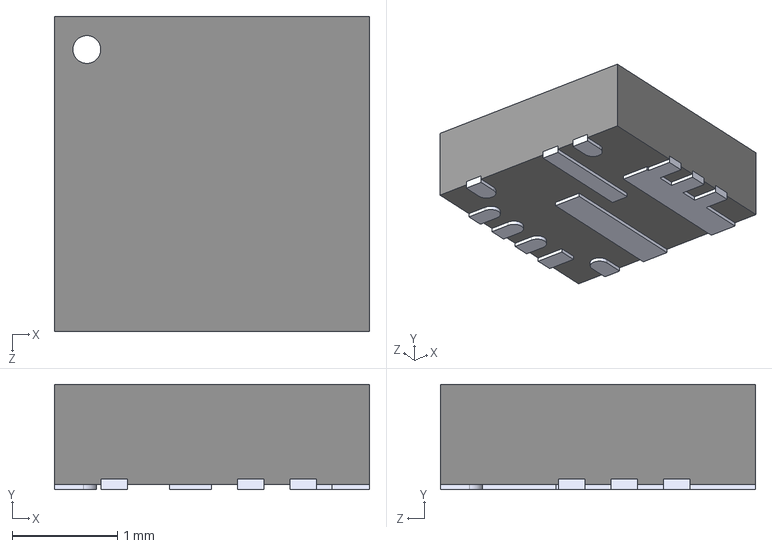
[picture p12: CAD file, 2026-02-22]
Designs/KiCAD Files/Custom Chip Files/models/TPS56637RPAR.step
3.00 x 1.00 x 3.00 mm
