Wildcat-Rocket-Engineering-Club/WRECtangle/(list of files, drawings)

Other design files:
Designs/KiCAD Files/WRECtangleVersions/V4.1/Wrectangle-V4/KiCAD_Elias_version/Connectors.SchDoc
Designs/KiCAD Files/WRECtangleVersions/V4.1/Wrectangle-V4/KiCAD_Elias_version/MB1136.PcbDoc
Designs/KiCAD Files/WRECtangleVersions/V4.1/Wrectangle-V4/KiCAD_Elias_version/MB1136.PrjPCB
Designs/KiCAD Files/WRECtangleVersions/V4.1/Wrectangle-V4/KiCAD_Elias_version/MB1136.SchDoc
Designs/KiCAD Files/WRECtangleVersions/V4.1/Wrectangle-V4/KiCAD_Elias_version/MB1136.SCHLIB
Designs/KiCAD Files/WRECtangleVersions/V4.1/Wrectangle-V4/KiCAD_Elias_version/MCU_64.SchDoc
Designs/KiCAD Files/WRECtangleVersions/V4.1/Wrectangle-V4/KiCAD_Elias_version/ST_LINK_V2-1.SCHDOC
