Wildcat-Rocket-Engineering-Club/WRECtangle/(commit log)

2026-02-07 WRECtangle V4 upload 1
    everything but the /WRECtangle/ folder
    [V3.kicad_pcb, V3.kicad_sch]
2026-02-13 Added schematics and assembly of deboard using same microcontroller
    [Connectors.SchDoc, MB1136.PcbDoc, MB1136.PrjPCB, MB1136.SCHLIB, MB1136.SchDoc, MCU_64.SchDoc, Nucleo_64_Assembly_F030R8.xlsx, Nucleo_64_Assembly_F103RB_L152RE_F072RB_F091RC_F334R8_L053R8_F303RE_F070RB_L073RZ.xlsx]
2026-02-14 Create WRECtangle V4.1
    Create WRECtangle V4.1
    [12V-5V-PowerCircuit.kicad_sch, 12V-PowerCircuit.kicad_sch, 24V-PowerCircuit.kicad_sch, 5V-PowerCircuit.kicad_sch, AnalogIsland.kicad_sch, Solenoid-Swithcing.kicad_sch, SolenoidToggling.kicad_sch, V3.kicad_pcb]
2026-02-14 Uploaded a USABLE version of the PCB
    From the 'archive project' tool in KiCAD
    [V3.kicad_pcb, V3.kicad_sch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]
2026-02-14 Update Wrectangle-V4.kicad_sch
    Fixed a wire.
    [Wrectangle-V4.kicad_sch]
2026-02-14 change grounds on Caps
    h
    [Wrectangle-V4.kicad_sch]
2026-02-14 Added a capacitor to CAP on BNO85
    [Wrectangle-V4.kicad_sch]
2026-02-14 removed evidence of ai
    Removed optional assistance suggestions from PCB review summary.
2026-02-21 Update some schematics (1x)
    2-20-26 fixed (#1)
    [24V-PowerCircuit.kicad_sch]
2026-02-21 more wrectangle updates
    again
    [Wrectangle-V4.kicad_sch]
2026-02-21 Update 24V-PowerCircuit.kicad_sch
    added many not connect
    [AnalogIsland.kicad_sch, Wrectangle-V4.kicad_sch]
2026-02-21 Update Wrectangle-V4.kicad_sch
    added no connect markers
    [Wrectangle-V4.kicad_sch]
2026-02-21 updating section
    [Board1.kicad_sch, Reflow_oven.kicad_pcb, Reflow_oven.kicad_sch, wrectangle_power_module.kicad_sch, wrectangle_sensors.kicad_sch]
2026-02-21 Update 24V-PowerCircuit.kicad_sch
    changed 12V pin on 24V power to output pin type
    [24V-PowerCircuit.kicad_sch]
2026-02-21 Rollback
    Fix it
    [Wrectangle-V4.kicad_sch]
2026-02-21 all but one ERC error????
    MAYBE??
    [24V-PowerCircuit.kicad_sch, Wrectangle-V4.kicad_sch, power.kicad_sch]
2026-02-21 Error Free!
    yay.
    [24V-PowerCircuit.kicad_sch, power.kicad_sch]
2026-02-21 Another update.
    Yeah.
    [Wrectangle-V4.kicad_sch]
2026-02-21 yet another WRECtangle edit
    [Wrectangle-V4.kicad_sch]
2026-02-21 more edits
    mainly aesthetic in the schematic
    [Wrectangle-V4.kicad_sch]
2026-02-21 Began MCU edits
    [Connectors.SchDoc, Elias_version_4.1.kicad_pcb, Elias_version_4.1.kicad_sch, MB1136.PcbDoc, MB1136.PrjPCB, MB1136.SCHLIB, MB1136.SchDoc, MCU_64.SchDoc]
2026-02-21 made some more edits on mcu
    [Elias_version_4.1.kicad_sch, stm32f1_programmer.kicad_sch]
2026-02-22 made a few more edits to the mcu
    [Elias_version_4.1.kicad_sch, stm32f1_programmer.kicad_sch]
2026-02-22 upload some custom chip symbols & files
    [1x2-ScrewTerminal.step, BME280.step, BNO085.step, H3LIS331DLTR.step, LTC2344CUH-16_PBF.step, MAX-M10S-00B.step, SMA-Connector.stp, STM32F405RGT6.step]
2026-02-26 add sheets
    [ADS1255-7 Calculator.xlsx]
2026-03-04 Change MCU
    Changed the microcontroller in the platformio.ini configuration to match the STM32 Nucleo F446RE board that we actually have.
